yrxyear/Active-Noise-Cancelling-Method-for-An-Electro-Optical-Detection-System/dissertation-sheet.tex

% this file is used by HDR these to generate the formal
% Thesis/Dissertation Sheet

\ThesisFamilyName{Yang}
\ThesisGivenName{Ruixing}
\ThesisOtherNames{} %if any, set to {} if not used

\ThesisAbbreviatedDegree{MPhil}

\begin{ThesisAbstract}

\end{ThesisAbstract}
