yrxyear/Active-Noise-Cancelling-Method-for-An-Electro-Optical-Detection-System/1-pre/abstract.tex

\chapter{Abstract}

An optical-electrode or ``Optrode'' is a recently developed nerve signal detection device. Optrodes are used in electro-optical detection systems to convert nerve signals into light signals. Compared to conventional electrode detection systems, this system has the advantages of lower electrical interference, low signal attenuation, and small volume. However, the current electro-optical systems' output noise levels are much higher compare to conventional electrode systems. This means it is harder to observe nerve activity, especially when the amplitude is small. Noise in the optrode system is mainly produced by the light source, which suggests the possibility of active noise canceling.

An active noise canceling method for the electro-optical detection system for better detection results is proposed in this project. By using a light splitter at the output of the light source, two channels of light that contain almost identical noise can be formed. By connecting the exact same optrode sensing circuit to the two channels, the noise output of the two channels is very similar. Then, by applying a nerve signal to the optrode in one channel and a zero signal to the optrode in the other channel, we get one channel to output a combination of noise and nerve signals, and the other channel to output only noise. By converting the light signals into digital signals and applying a suitable digital signal processing algorithm, the noise can be largely removed and a clean nerve signal can be recovered.

In this project, a light receiver board which converts and amplifies two channels of light to digital signals has been designed, constructed and tested.  The digitised signals from the light receiver board receiver board are passed to an FPGA development board on which an adaptive filter algorithm has been implemented to actively cancel the noise. Experiments were conducted to test the system noise floor, and the system's responses to sine wave signals and simulated cardiac signals applied to the active optrode. Results show up to a 50\% reduction of the receiver system's noise floor when the active noise cancelling was activated, thus the ability to recover very low amplitude signals.  It can also reduce the artifact caused by moving the system physically.
