yrxyear/Active-Noise-Cancelling-Method-for-An-Electro-Optical-Detection-System/1-pre/publications.tex

\chapter{Publications and Presentations}

\section*{List of Publications}
 
\begin{itemize}
    \item R. Yang, Y. Chen, F. Ladouceur, N. H. Lovell, A. Al Abed, and T. Lehmann, ``Active Noise Cancelling Method for An Electro-Optical Detection System,'' 2023 IEEE Nordic Circuits and Systems Conference (NorCAS), 2023, Accepted on Sept. 20, 2023.
\end{itemize}
