yrxyear/Active-Noise-Cancelling-Method-for-An-Electro-Optical-Detection-System/1-pre/abbreviations.tex

%\chapter{Abbreviations}

%%cat */*.tex | grep -wo "[A-Z]\+\{2,10\}" | sort | uniq -c | awk '{print $2}'

\nomenclature{RMS}{Root Mean Square}
\nomenclature{PM}{Polarization-maintaining}
\nomenclature{RF}{Radio Frequency}
\nomenclature{PCB}{Printed Circuit Board}
\nomenclature{FPGA}{Field Programmable Gate Array}
\nomenclature{HDL}{Hardware Description Language}
\nomenclature{DSP}{Digital Signal Processing}
\nomenclature{FIR}{Finite Impulse Response}
\nomenclature{FxLMS}{Filtered-X Least Mean Squares}
\nomenclature{ANC}{Active Noise Cancelling}
\nomenclature{LMS}{Least Mean Square}
\nomenclature{LUT}{Look Up Table}
\nomenclature{IOB}{Input Output Block}
\nomenclature{IO}{Input Output}
\nomenclature{AC}{Alternating Current}
\nomenclature{DC}{Direct Current}
\nomenclature{MOSFET}{Metal-oxide-semiconductor Field-effect Transistor}
\nomenclature{EMI}{Electromagnetic Interference}
\nomenclature{DAC}{Digital-to-Analog Converter}
\nomenclature{ADC}{Analog-to-Digital Converters}
\nomenclature{SPI}{Serial Peripheral Interface}
\nomenclature{I2C}{Inter-Integrated Circuit}
\nomenclature{LDO}{Low-dropout}
\nomenclature{BCI}{Brain-computer Interface}
\nomenclature{RTL}{Register-transfer Level}
\nomenclature{USB}{Universal Serial Bus}
\nomenclature{APSoCs)}{All Programmable System-on-Chips}
\nomenclature{PC}{Personal Computer}
\nomenclature{LED}{Light Emitting Diode}
\nomenclature{SD Card}{Secure Digital Card}
\nomenclature{FIFO}{First In First Out}

\printnomenclature[5em]
