yrxyear/Active-Noise-Cancelling-Method-for-An-Electro-Optical-Detection-System/3-literature/zero_mode_sch.png

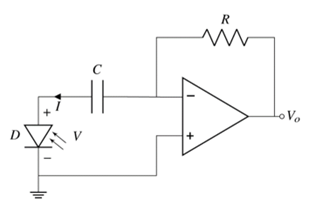
3-literature/zero_mode_sch.png
