yrxyear/Active-Noise-Cancelling-Method-for-An-Electro-Optical-Detection-System/5-Experiment/Cross correlation.pdf

100 | 200 | 300 | 400 | 500 | 600 | 700 | 800
Light Source Current (mA)

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
Cross correlation at 0 lag
