yrxyear/Active-Noise-Cancelling-Method-for-An-Electro-Optical-Detection-System/5-Experiment/RMS for Signal and Noise.pdf

RMS

200 | 300 | 400 | 500 | 600 | 700 | 800
Light Source Current (mA)

0

0.1

0.2

0.3

0.4

0.5

Voltage (V)

Signal RMS
Noise RMS
