yrxyear/Active-Noise-Cancelling-Method-for-An-Electro-Optical-Detection-System/5-Experiment/RMS value for ch1 and DSP output.pdf

100 | 200 | 300 | 400 | 500 | 600 | 700 | 800
Light Source Current (mA)

0

0.005

0.01

0.015

0.02

0.025

0.03

0.035

0.04

0.045

Voltage (V)

Active Optrode
Noise Canceling Output
