yrxyear/Active-Noise-Cancelling-Method-for-An-Electro-Optical-Detection-System/5-Experiment/Signal RMS (10mV input).pdf

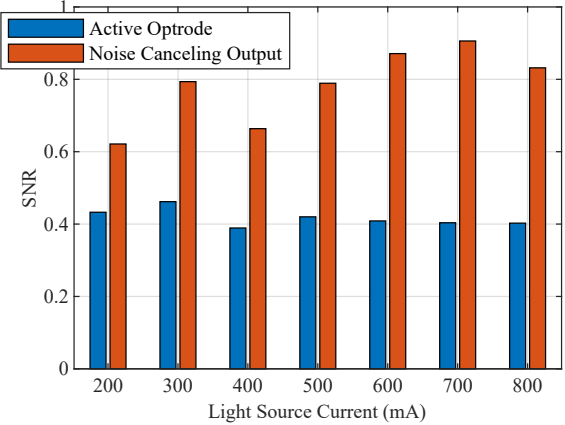
[picture p11: figure]
Light Source Current (mA); SNR; Active Optrode Noise Canceling Output
