yrxyear/Active-Noise-Cancelling-Method-for-An-Electro-Optical-Detection-System/5-Experiment/Signal to Noise Ratio of 200mV Input Amplitude.pdf

Signal to Noise Ratio of 200mV Input Amplitude

200 | 300 | 400 | 500 | 600 | 700 | 800
Light Source Current (mA)

0

5

10

15

20

25

30

Signal to Noise Ratio

Original Noise
Noise after ANC
