yrxyear/Active-Noise-Cancelling-Method-for-An-Electro-Optical-Detection-System/5-Experiment/SNR (10mV input).pdf

200 | 300 | 400 | 500 | 600 | 700 | 800
Light Source Current (mA)

0

0.2

0.4

0.6

0.81

1.2

SNR

Active Optrode
Noise Canceling Output
200 | 300 | 400 | 500 | 600 | 700 | 800
Light Source Current (mA)

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
SNR improvement (%)
