yrxyear/Active-Noise-Cancelling-Method-for-An-Electro-Optical-Detection-System/5-Experiment/SNR (200mV input).pdf

200 | 300 | 400 | 500 | 600 | 700 | 800
Light Source Current (mA)

02468

10

12

14

SNR

Active Optrode
Noise Canceling Output
200 | 300 | 400 | 500 | 600 | 700 | 800
Light Source Current (mA)

0

10

20

30

40

50

60

SNR improvement (%)
