yrxyear/Active-Noise-Cancelling-Method-for-An-Electro-Optical-Detection-System/5-Experiment/SNR improvment.pdf

SNR improvment

200 300 400 500 600 700 800 Light Source Current (mA)

0

0.5

1

1.5

2

2.5

SNR improvment
