yrxyear/Active-Noise-Cancelling-Method-for-An-Electro-Optical-Detection-System/4-ANC_Sys/SimulinkResult.pdf

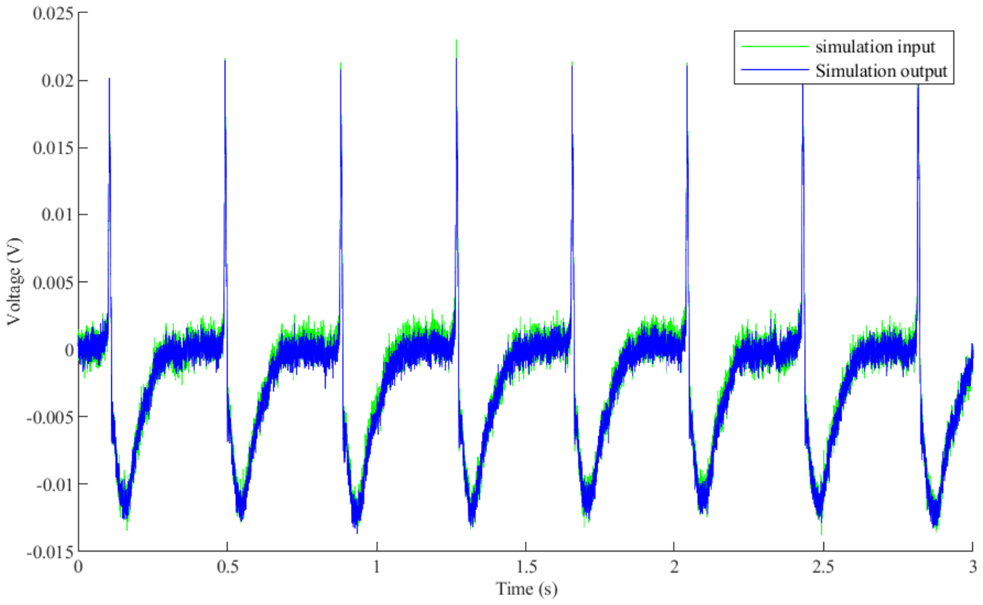
[picture p12: page 1]
