yrxyear/Active-Noise-Cancelling-Method-for-An-Electro-Optical-Detection-System/4-ANC_Sys/ReceiverAmplifierBoardSchematic_23_5_2023.pdf

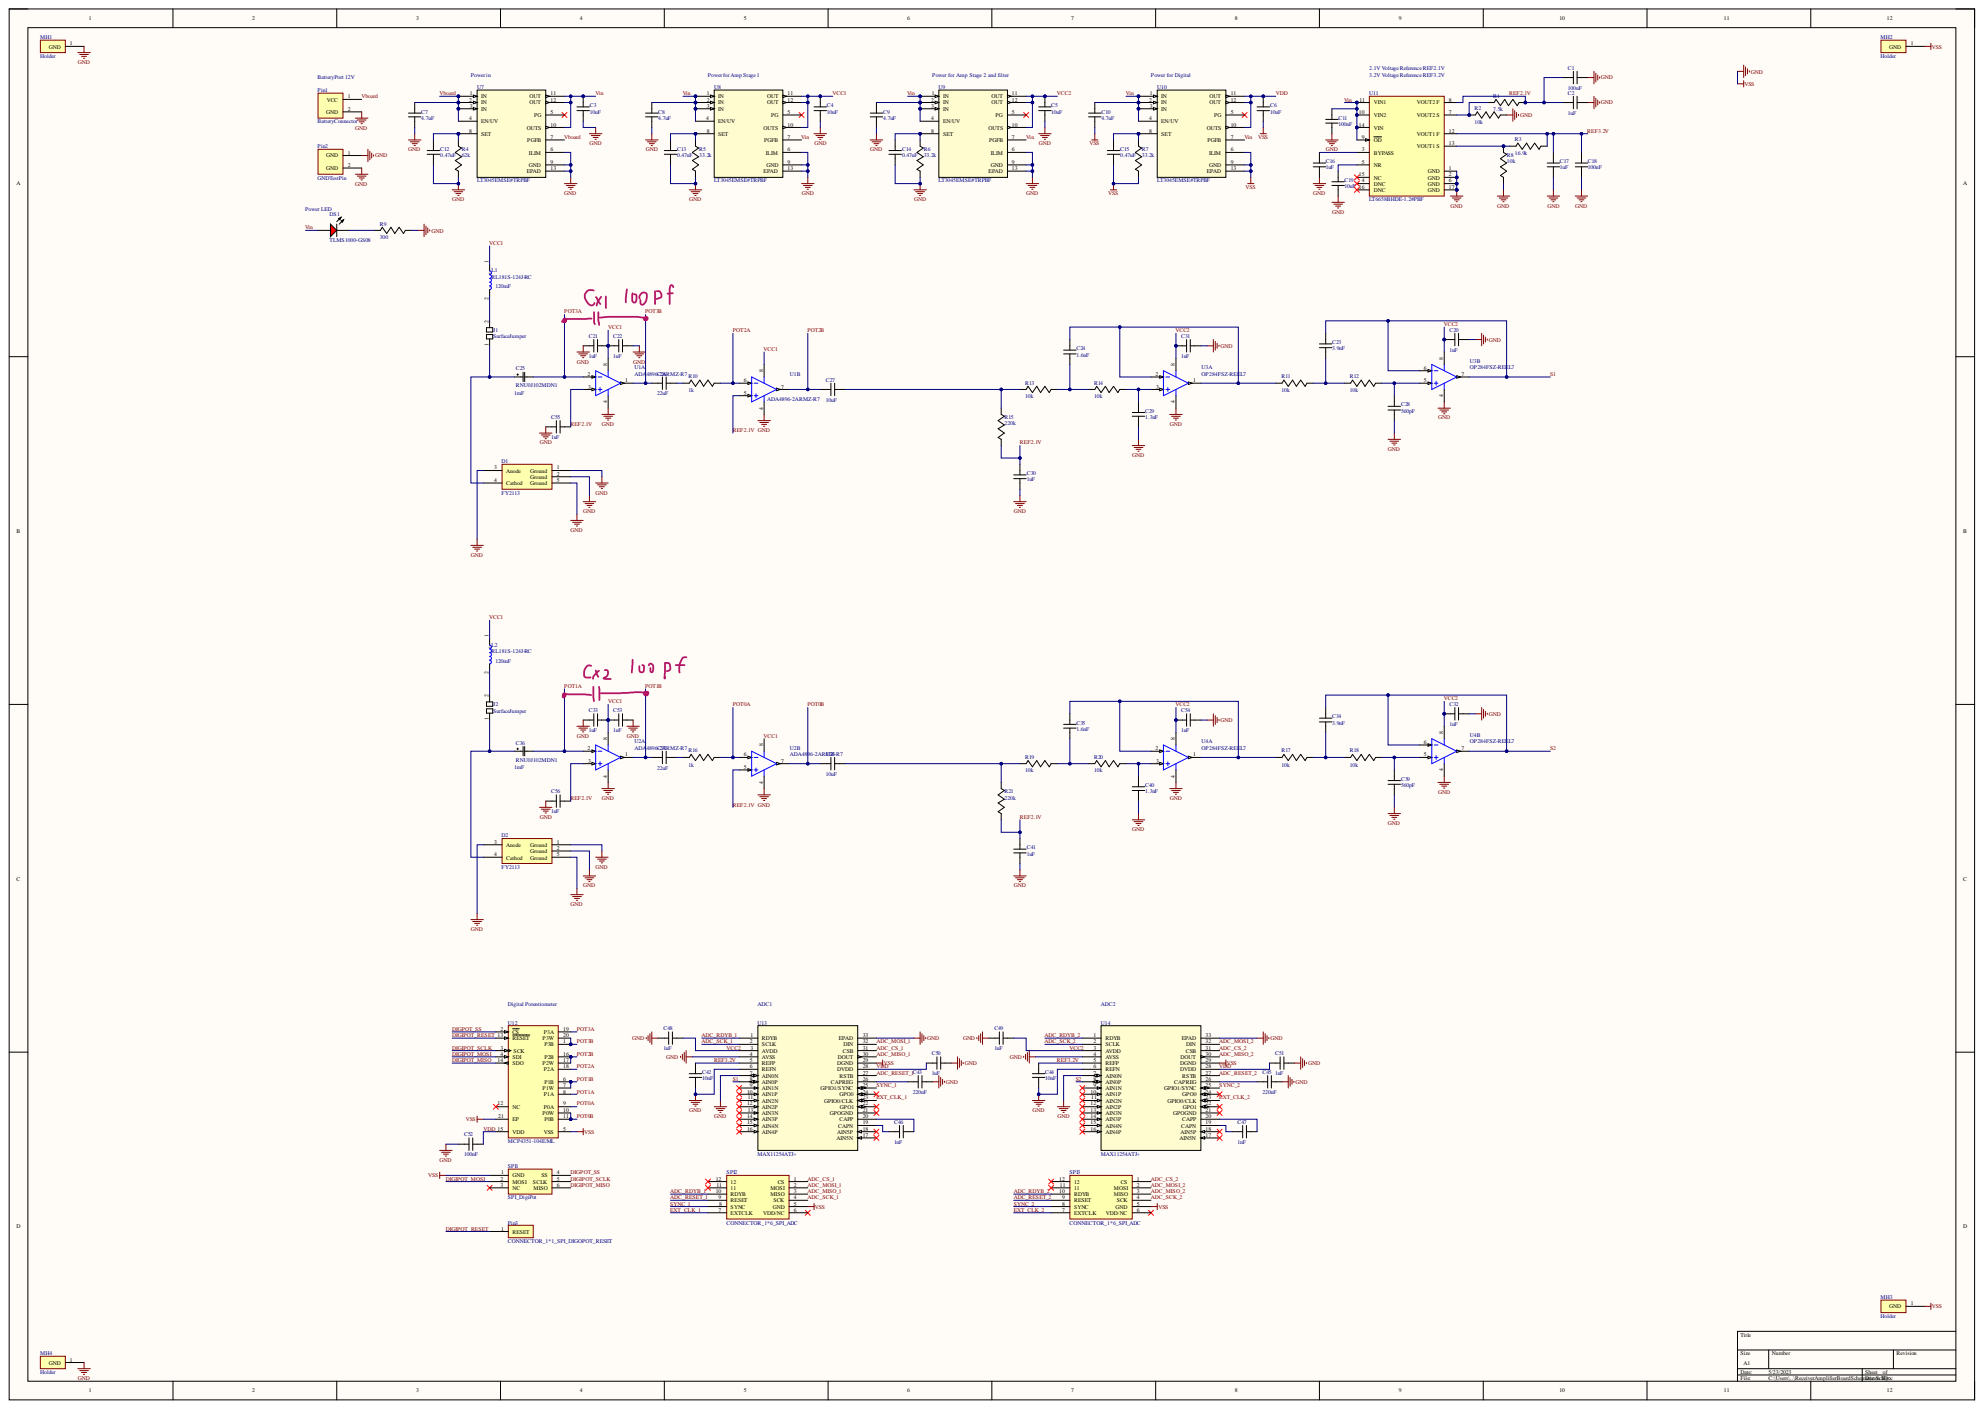
[picture p13: page 1]

Anode 3 Ground Cathod 4 Ground | 2
