yrxyear/Active-Noise-Cancelling-Method-for-An-Electro-Optical-Detection-System/5-Experiment/SimCardiac.pdf

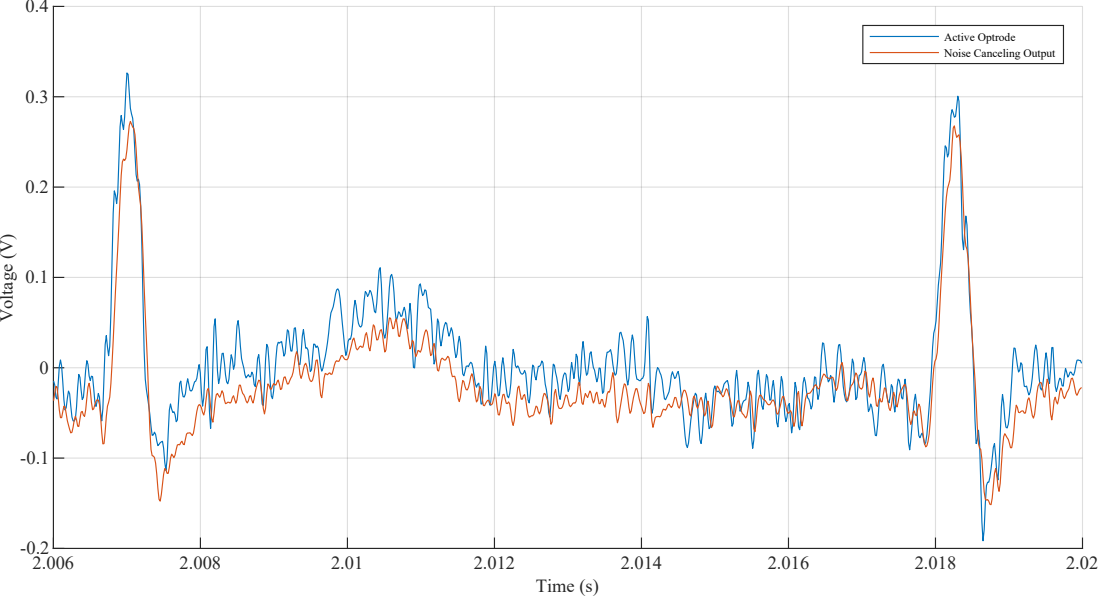
[picture p14: page 1]
Time (s); Voltage (V)

Active Optrode
Noise Canceling Output
