yrxyear/Active-Noise-Cancelling-Method-for-An-Electro-Optical-Detection-System/5-Experiment/500mA Signal_a.pdf

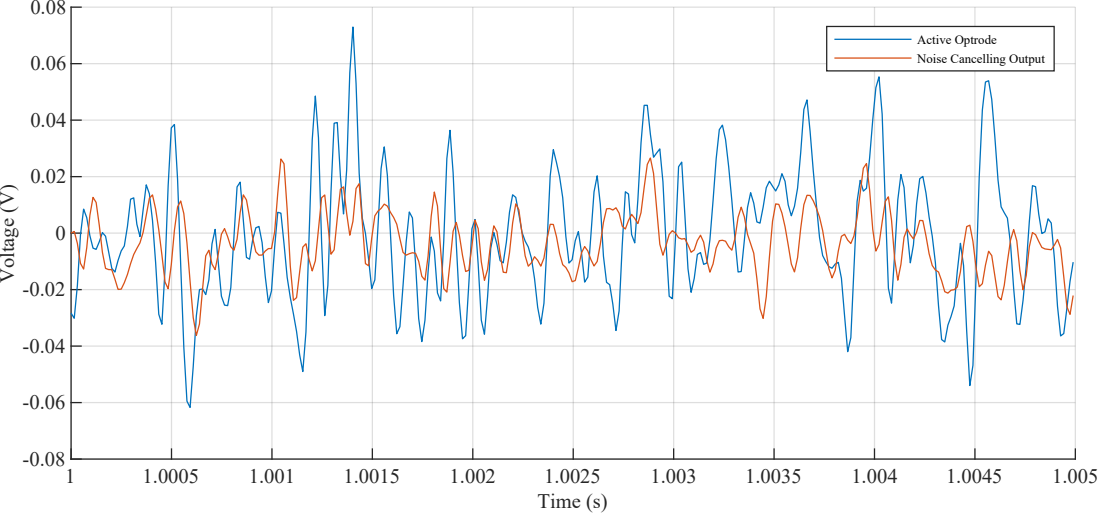
[picture p15: page 1]
Time (s); Voltage (V)

Active Optrode
Noise Cancelling Output
