yrxyear/Active-Noise-Cancelling-Method-for-An-Electro-Optical-Detection-System/5-Experiment/500mA Signal_c.pdf

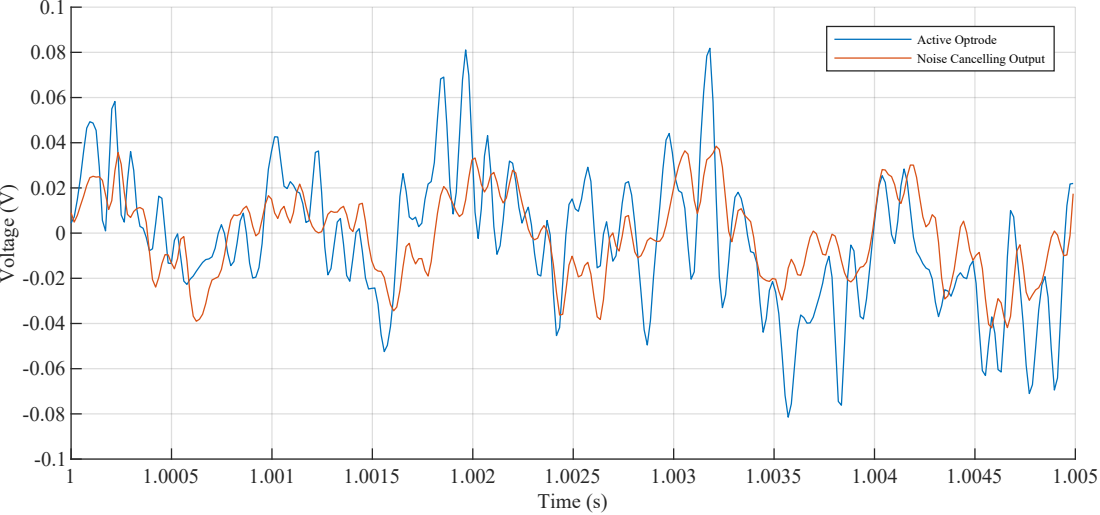
[picture p17: page 1]
Time (s); Voltage (V)

Active Optrode
Noise Cancelling Output
