yrxyear/Active-Noise-Cancelling-Method-for-An-Electro-Optical-Detection-System/4-ANC_Sys/CrossCoTest.pdf

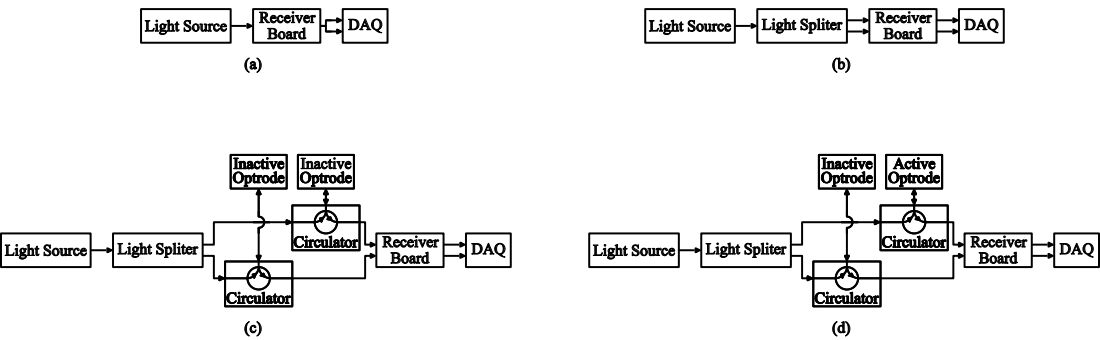
[picture p18: page 1]
Light Source; Receiver; Board; DAQ; Board Light Spliter; Inactive Optrode; Circulator; Optrode; Active Optrode; Inactive
