yrxyear/Active-Noise-Cancelling-Method-for-An-Electro-Optical-Detection-System/4-ANC_Sys/TestMeasurement.pdf

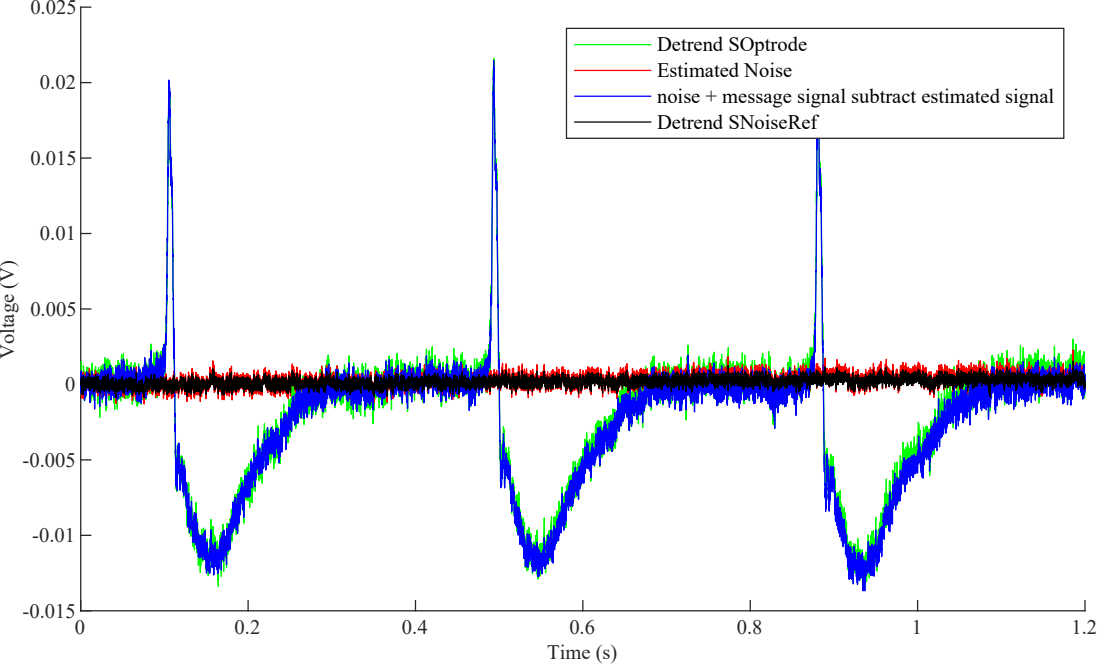
[picture p19: page 1]
Time (s); Voltage (V)

Detrend SOptrode
Estimated Noise
noise + message signal subtract estimated signal
Detrend SNoiseRef
