yrxyear/Active-Noise-Cancelling-Method-for-An-Electro-Optical-Detection-System/5-Experiment/500mA Signal.pdf

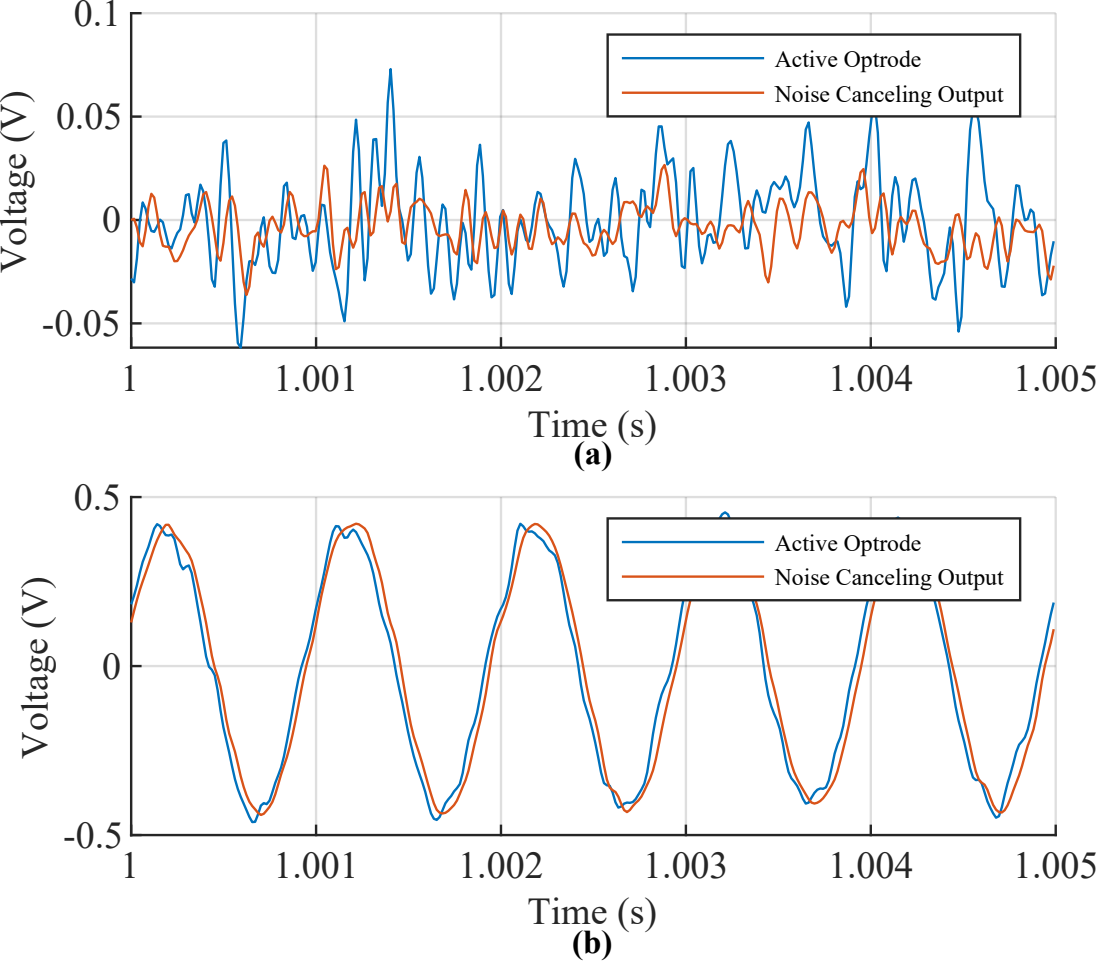
[picture p20: page 1]
Time (s); Voltage (V)

Active Optrode
Noise Canceling Output
