yrxyear/Active-Noise-Cancelling-Method-for-An-Electro-Optical-Detection-System/5-Experiment/Board Baseline Noise.pdf

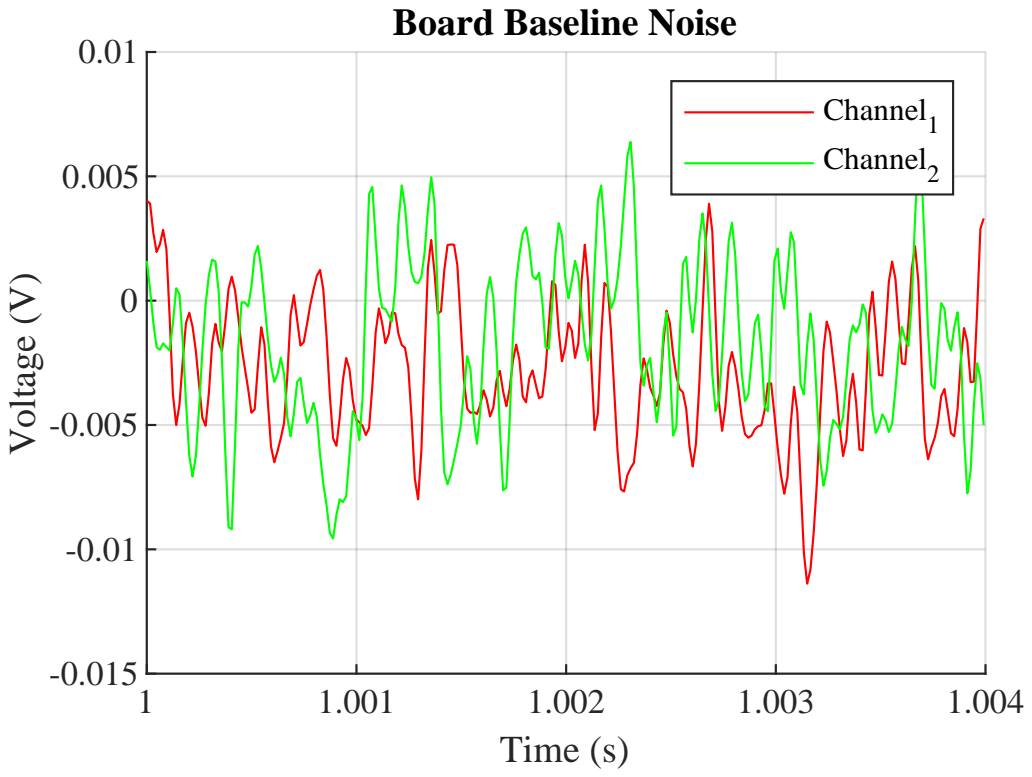
[picture p21: page 1]
Time (s); Voltage (V); Channel1 Channel2

Board Baseline Noise
