yrxyear/Active-Noise-Cancelling-Method-for-An-Electro-Optical-Detection-System/5-Experiment/Periodogram 500mA (10mV input).pdf

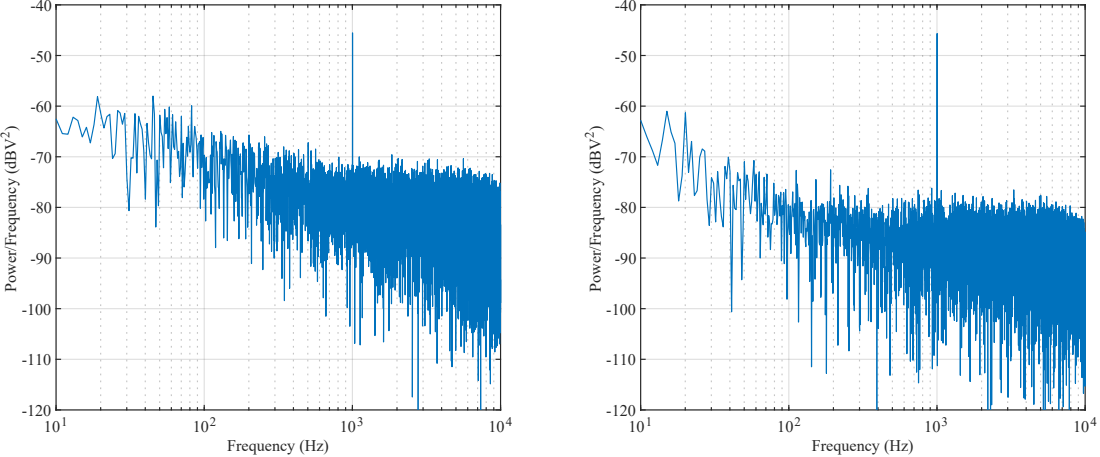
[picture p23: page 1]
Frequency (Hz); Power/Frequency (dBV2)
