yrxyear/Active-Noise-Cancelling-Method-for-An-Electro-Optical-Detection-System/4-ANC_Sys/NoiseZeroMode.pdf

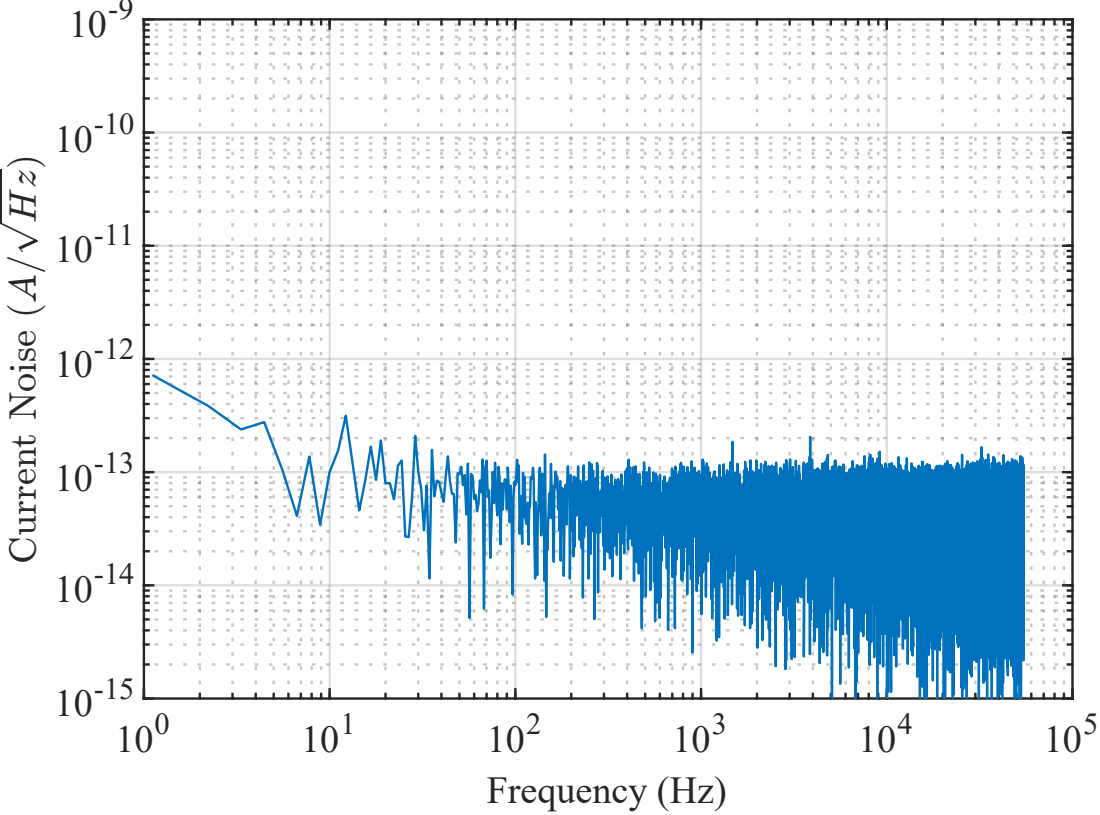
[picture p24: page 1]
Frequency (Hz)

Current Noise (A=pHz)
