yrxyear/Active-Noise-Cancelling-Method-for-An-Electro-Optical-Detection-System/4-ANC_Sys/PowerSupSch.pdf

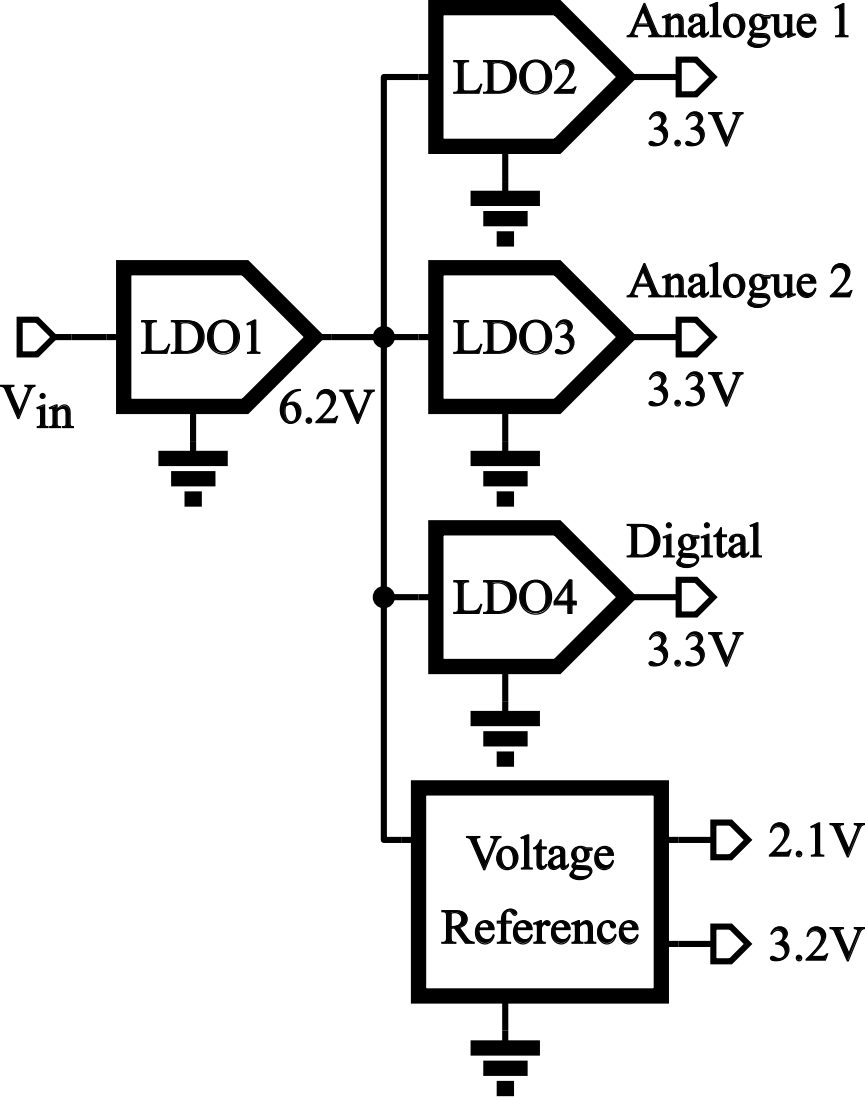
[picture p25: page 1]
LDO1; LDO3; LDO4; LDO2; Vin; Analogue 1; Analogue 2; Digital; Voltage Reference
