yrxyear/Active-Noise-Cancelling-Method-for-An-Electro-Optical-Detection-System/4-ANC_Sys/PCB_2.pdf

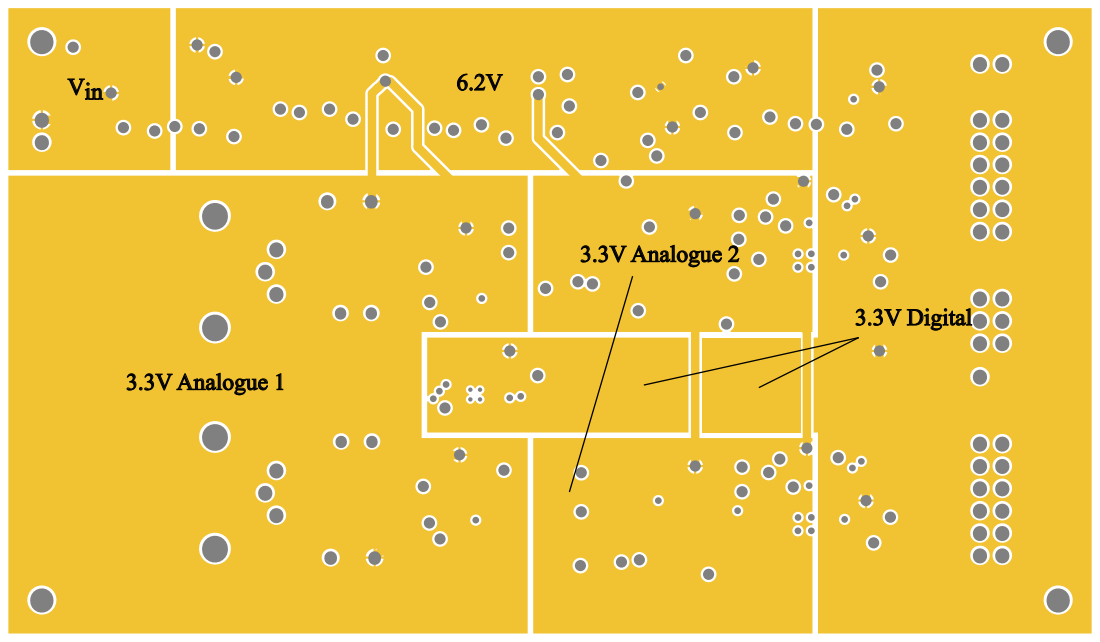
[picture p26: page 1]
3.3V Digital; Vin; 3.3V Analogue 1; 3.3V Analogue 2
