yrxyear/Active-Noise-Cancelling-Method-for-An-Electro-Optical-Detection-System/2-intro/OptrodeFigure.pdf

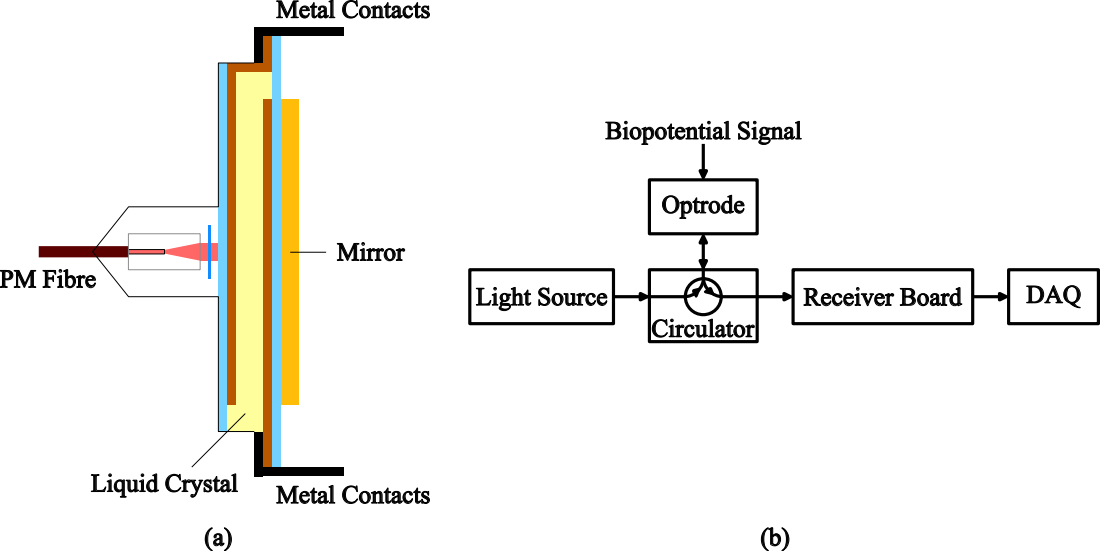
[picture p27: page 1]
PM Fibre; Liquid Crystal; Mirror; Metal Contacts; Circulator; Light Source; Optrode; Biopotential Signal; Receiver Board; DAQ
