yrxyear/Active-Noise-Cancelling-Method-for-An-Electro-Optical-Detection-System/4-ANC_Sys/ANCBlockDiagram.pdf

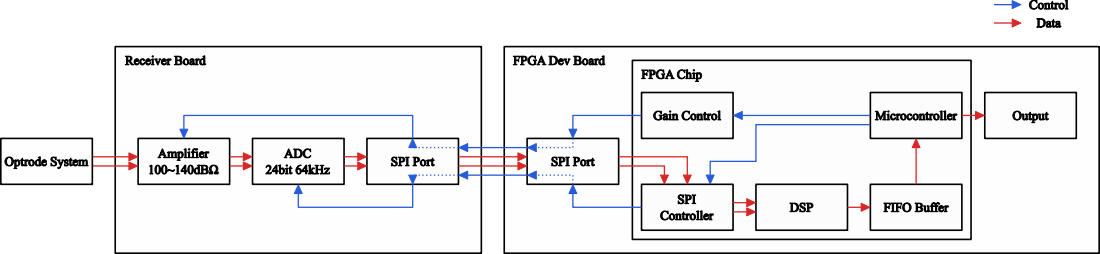
[picture p28: page 1]
Amplifier; 100~140dBΩ; SPI Port; Gain Control; Microcontroller; Output; DSP; FIFO Buffer; ADC 24bit 64kHz; SPI Controller; Receiver Board; FPGA Dev Board; FPGA Chip; Optrode System; Control Data
