yrxyear/Active-Noise-Cancelling-Method-for-An-Electro-Optical-Detection-System/4-ANC_Sys/ANCSysBlockDiagram.pdf

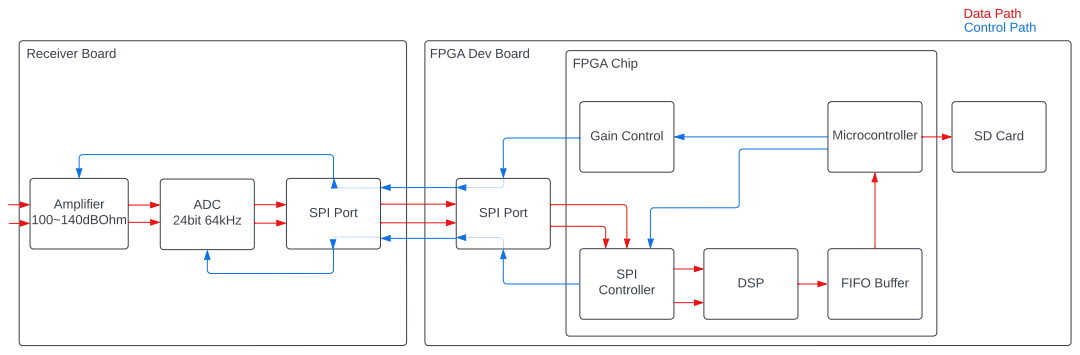
[picture p29: page 1]
Data Path; FPGA Chip; Amplifier 100~140dBOhm; ADC 24bit 64kHz; SPI Port; Gain Control; FIFO Buffer; SPI; Controller; DSP; Microcontroller; SD Card; Receiver Board; FPGA Dev Board; Control Path
