yrxyear/Active-Noise-Cancelling-Method-for-An-Electro-Optical-Detection-System/4-ANC_Sys/LTspiceAmp.pdf

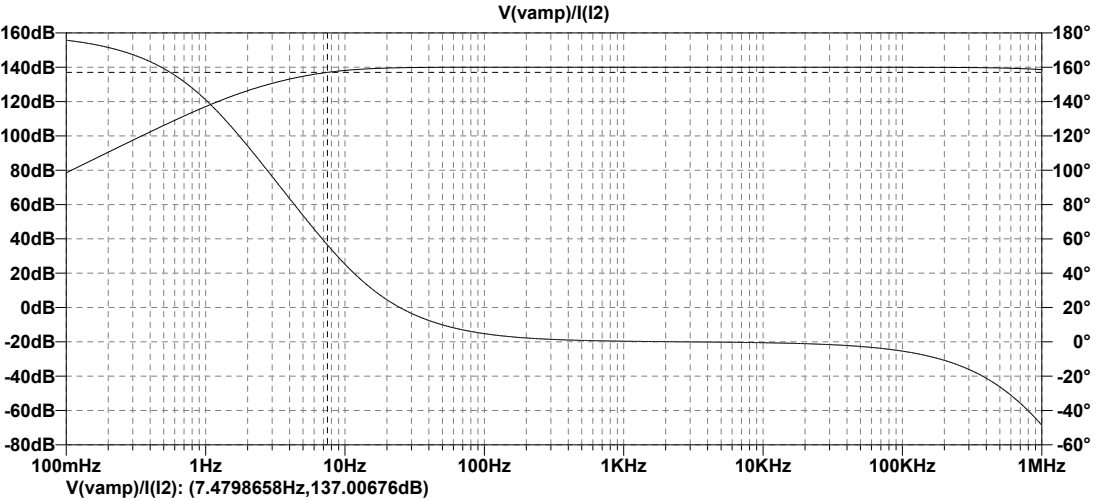
[picture p30: page 1]
100mHz; 1KHz; 10KHz; 100KHz; 1MHz; V(vamp)/I(I2); V(vamp)/I(I2): (7.4798658Hz,137.00676dB) --- C:\Users\Rex\OneDrive\#UNSW\#MASTER\# PCB&FPGA\LTsice\ReceiverFilter.asc ---
