yrxyear/Active-Noise-Cancelling-Method-for-An-Electro-Optical-Detection-System/4-ANC_Sys/LTspiceLPF.pdf

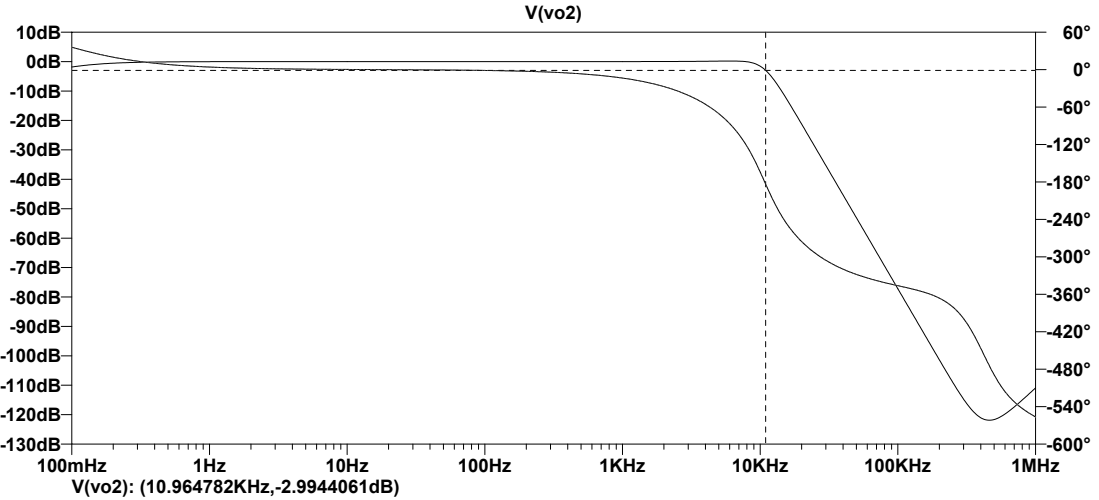
[picture p31: page 1]
100mHz; 1KHz; 10KHz; 100KHz; 1MHz; V(vo2): (10.964782KHz,-2.9944061dB) --- C:\Users\Rex\OneDrive\#UNSW\#MASTER\# PCB&FPGA\LTsice\ReceiverFilter.asc ---
