yrxyear/Active-Noise-Cancelling-Method-for-An-Electro-Optical-Detection-System/4-ANC_Sys/NoiseReverseBias.pdf

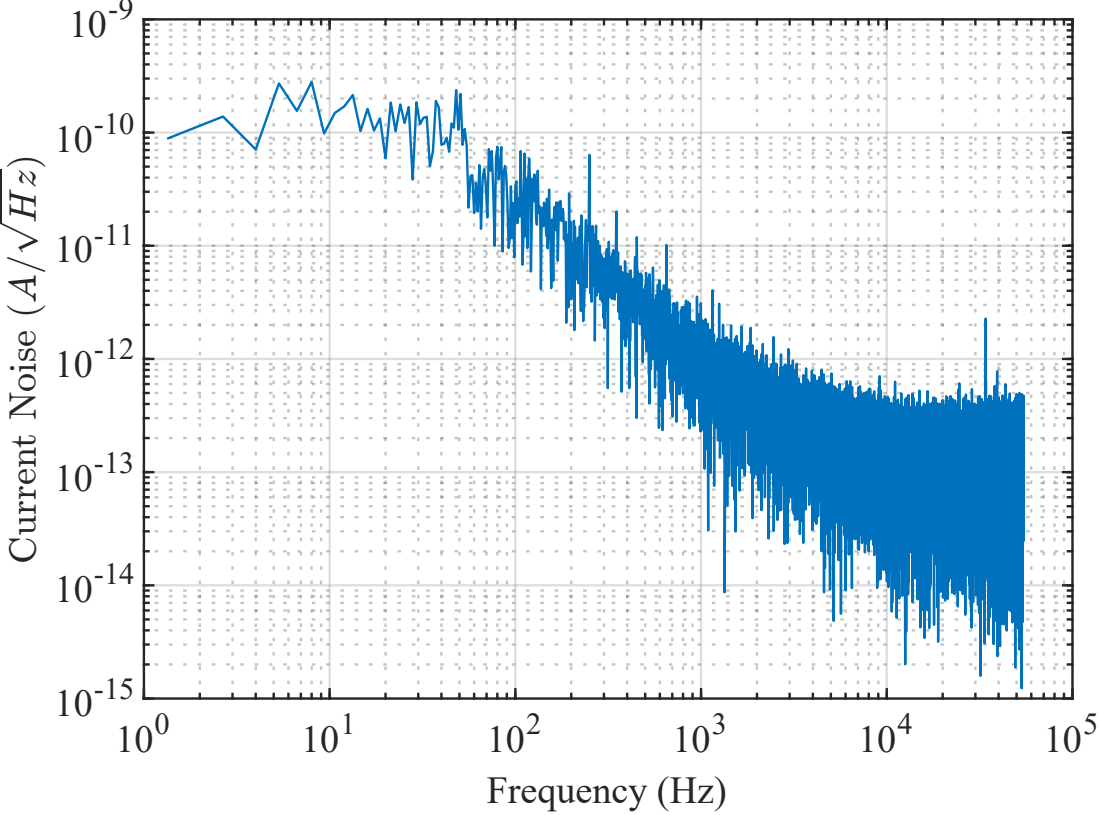
[picture p32: page 1]
Frequency (Hz)

Current Noise (A=pHz)
