yrxyear/Active-Noise-Cancelling-Method-for-An-Electro-Optical-Detection-System/5-Experiment/CrossCoAfterANC.pdf

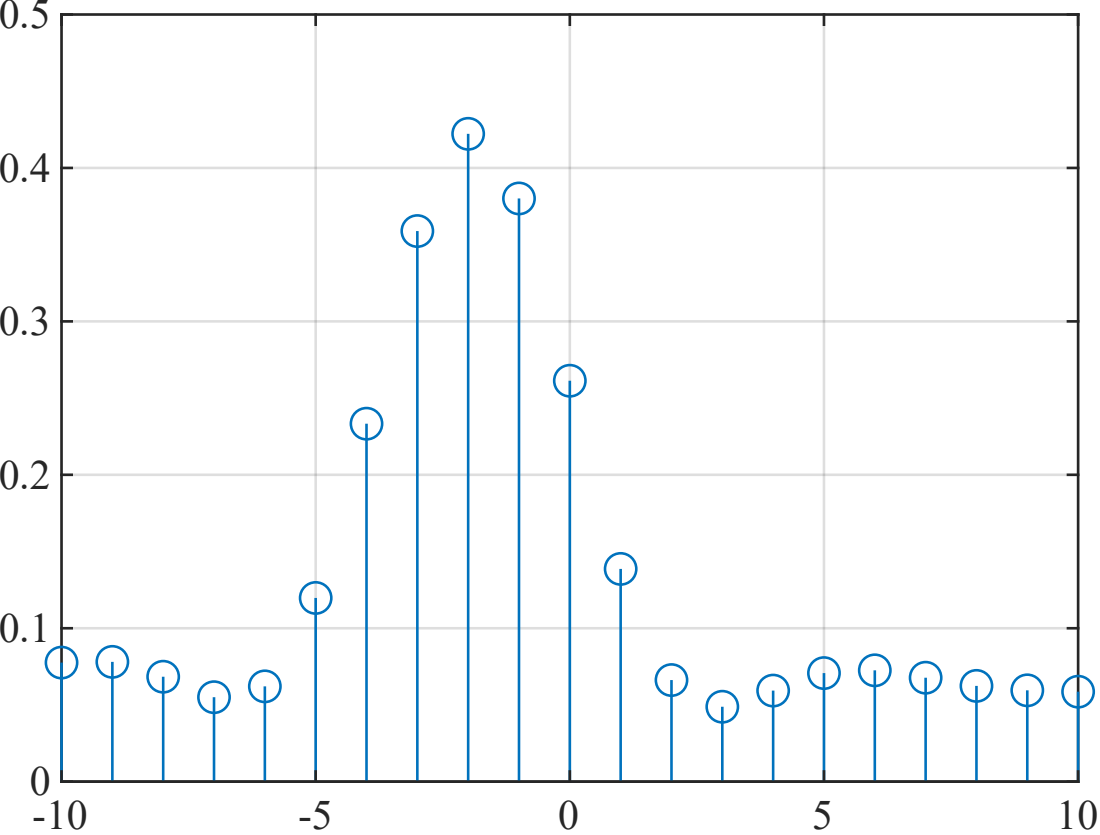
[picture p33: page 1]
