yrxyear/Active-Noise-Cancelling-Method-for-An-Electro-Optical-Detection-System/5-Experiment/CrossCoBeforeANC.pdf

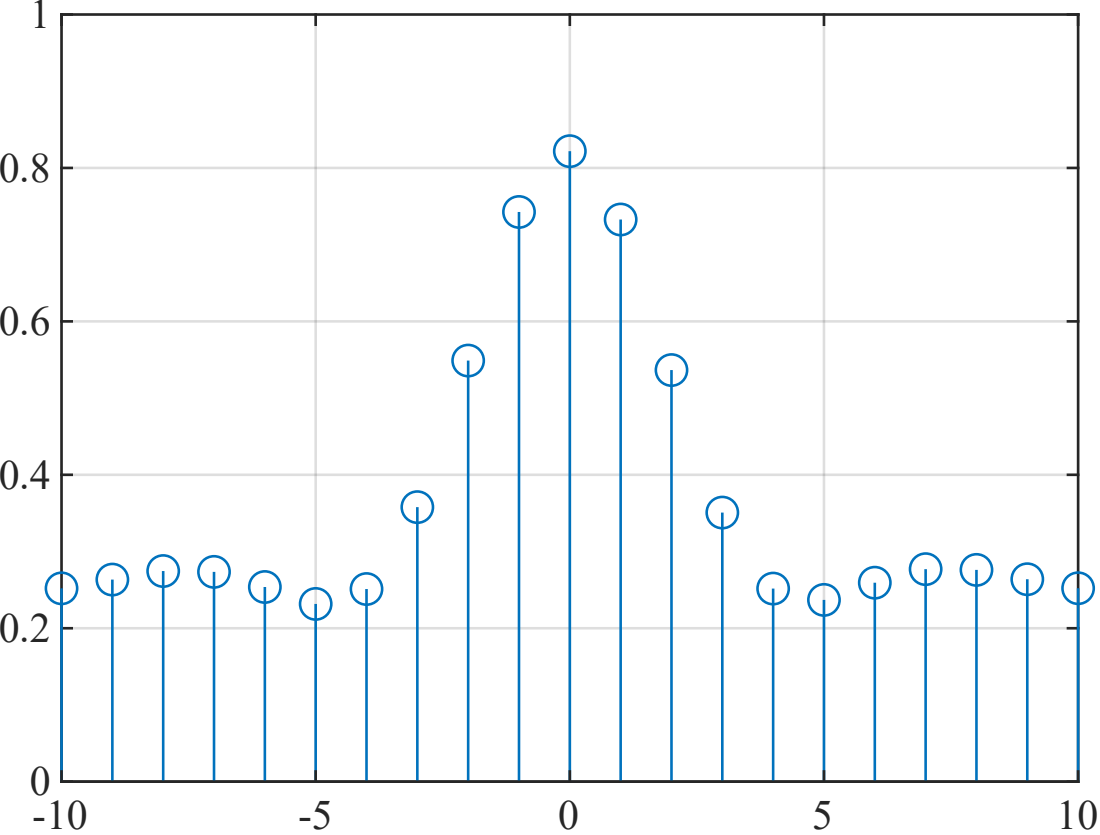
[picture p34: page 1]
