yrxyear/Active-Noise-Cancelling-Method-for-An-Electro-Optical-Detection-System/4-ANC_Sys/DSP.pdf

x
H

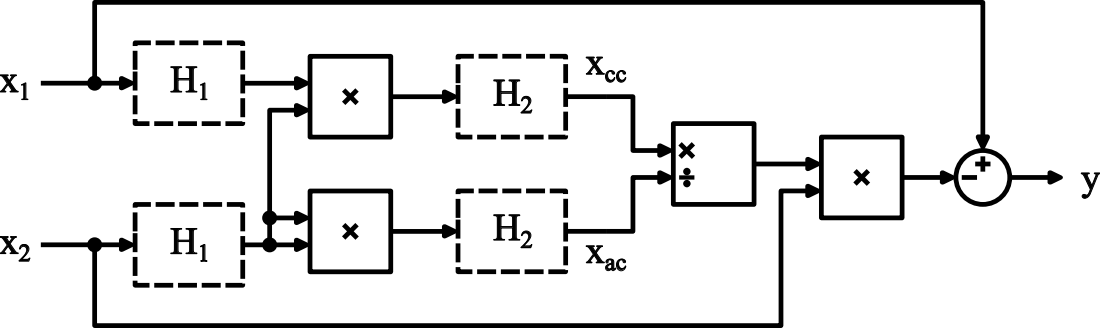
[picture p35: page 1]
