yrxyear/Active-Noise-Cancelling-Method-for-An-Electro-Optical-Detection-System/4-ANC_Sys/ModifiedWiener.pdf

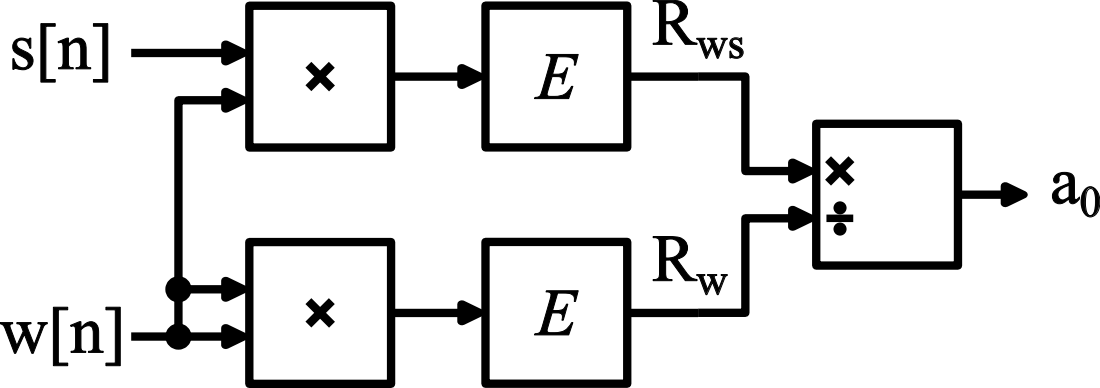
[picture p36: page 1]
