yrxyear/Active-Noise-Cancelling-Method-for-An-Electro-Optical-Detection-System/4-ANC_Sys/LTspiceAmpSch.pdf

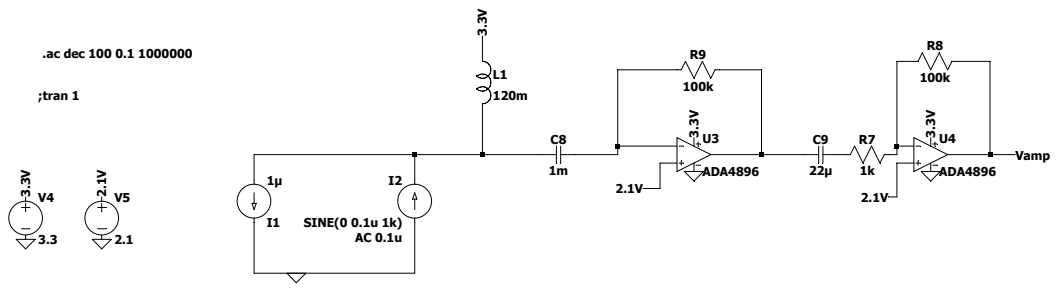
[picture p37: page 1]
