yrxyear/Active-Noise-Cancelling-Method-for-An-Electro-Optical-Detection-System/4-ANC_Sys/SallenKeyLPF.pdf

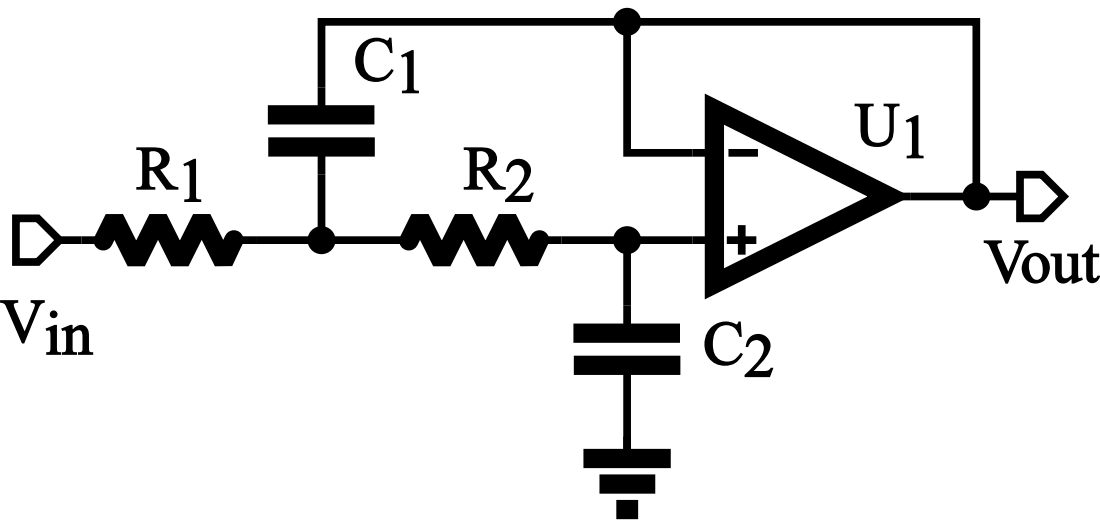
[picture p38: page 1]
