yrxyear/Active-Noise-Cancelling-Method-for-An-Electro-Optical-Detection-System/4-ANC_Sys/PCB_3.pdf

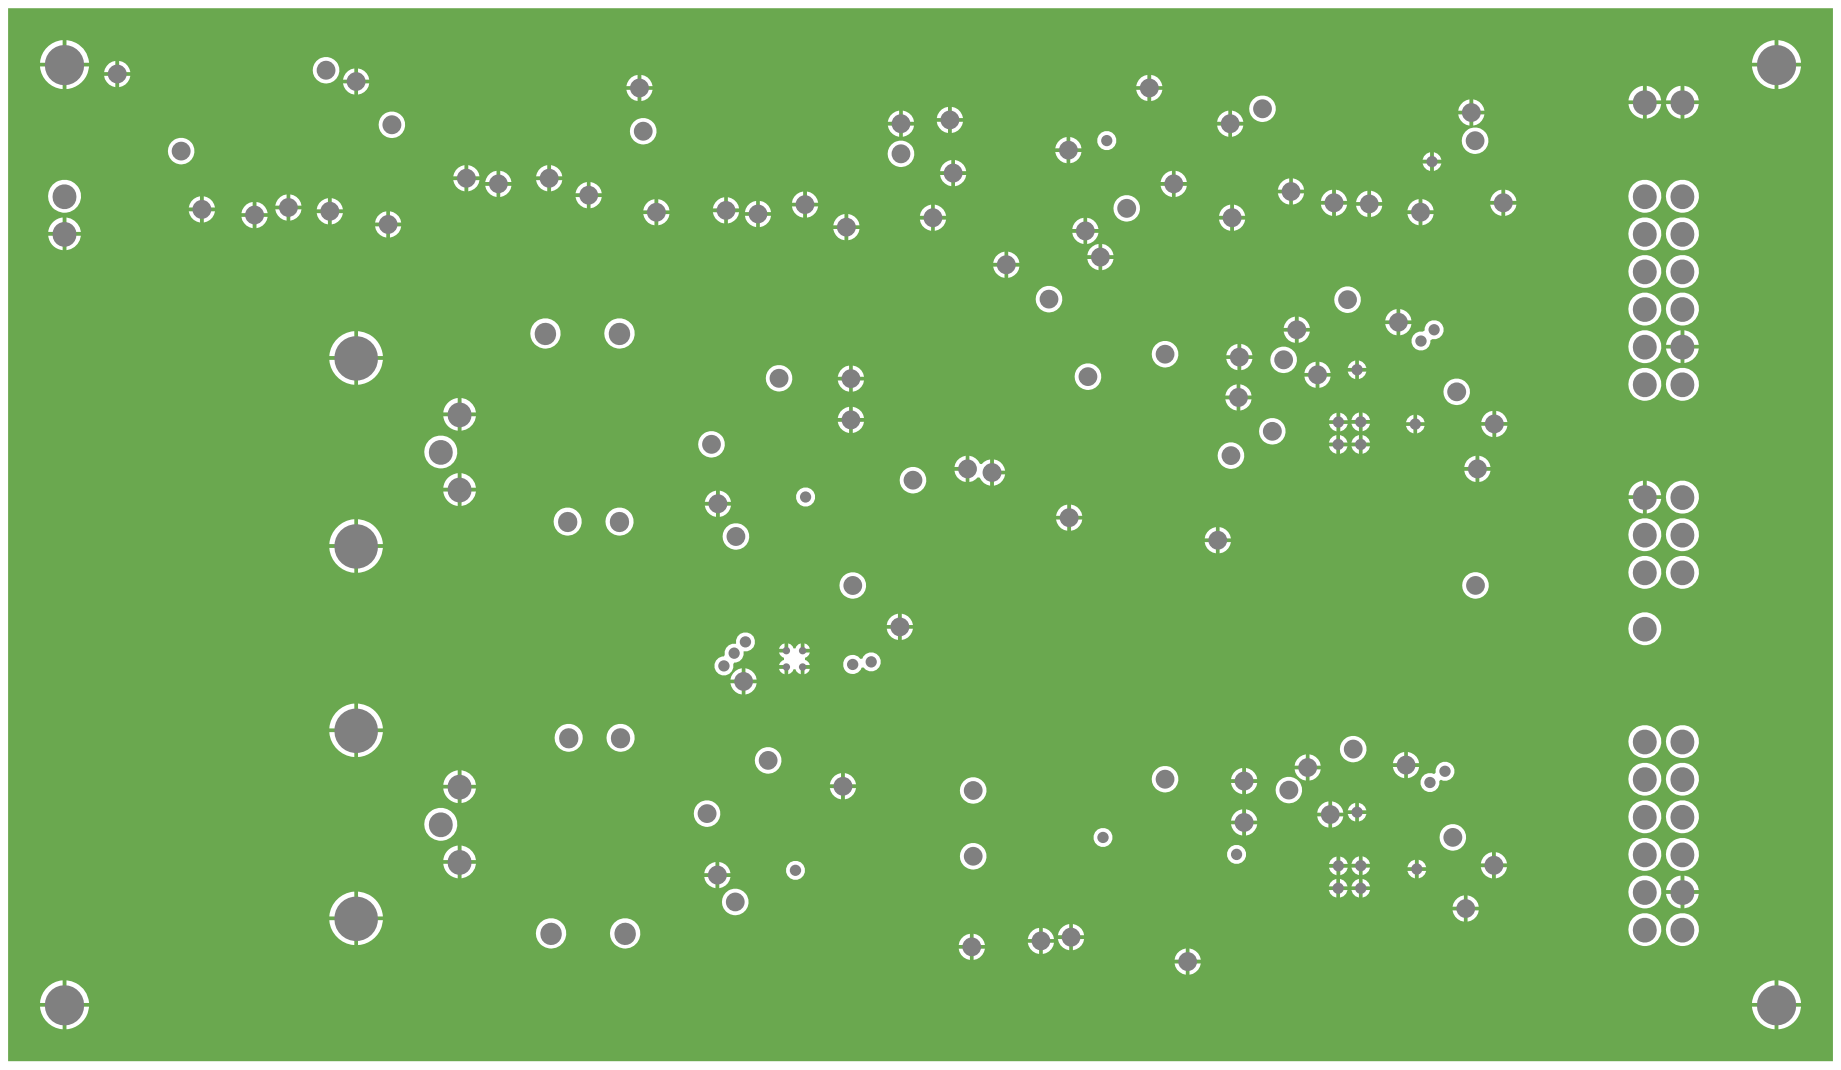
[picture p40: page 1]
