yrxyear/Active-Noise-Cancelling-Method-for-An-Electro-Optical-Detection-System/4-ANC_Sys/PCB_4.pdf

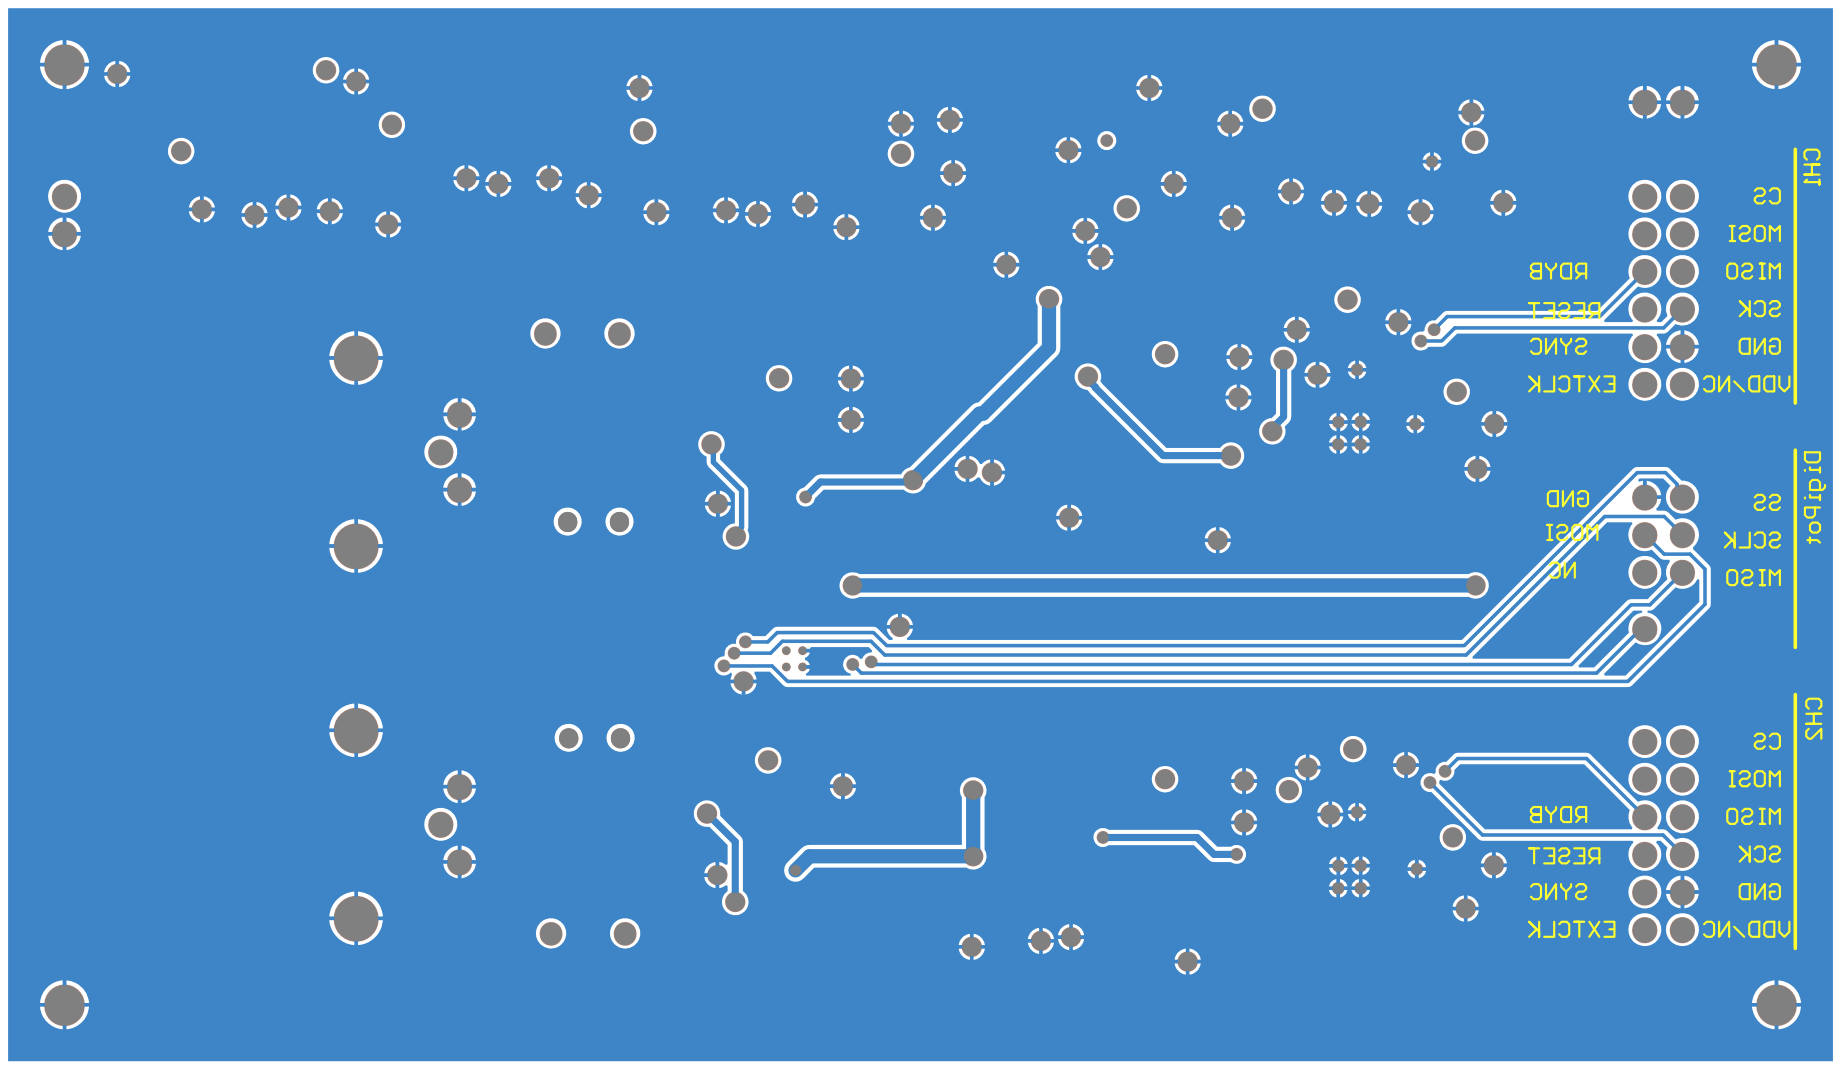
[picture p41: page 1]
