yrxyear/Active-Noise-Cancelling-Method-for-An-Electro-Optical-Detection-System/4-ANC_Sys/VivadoBD.pdf

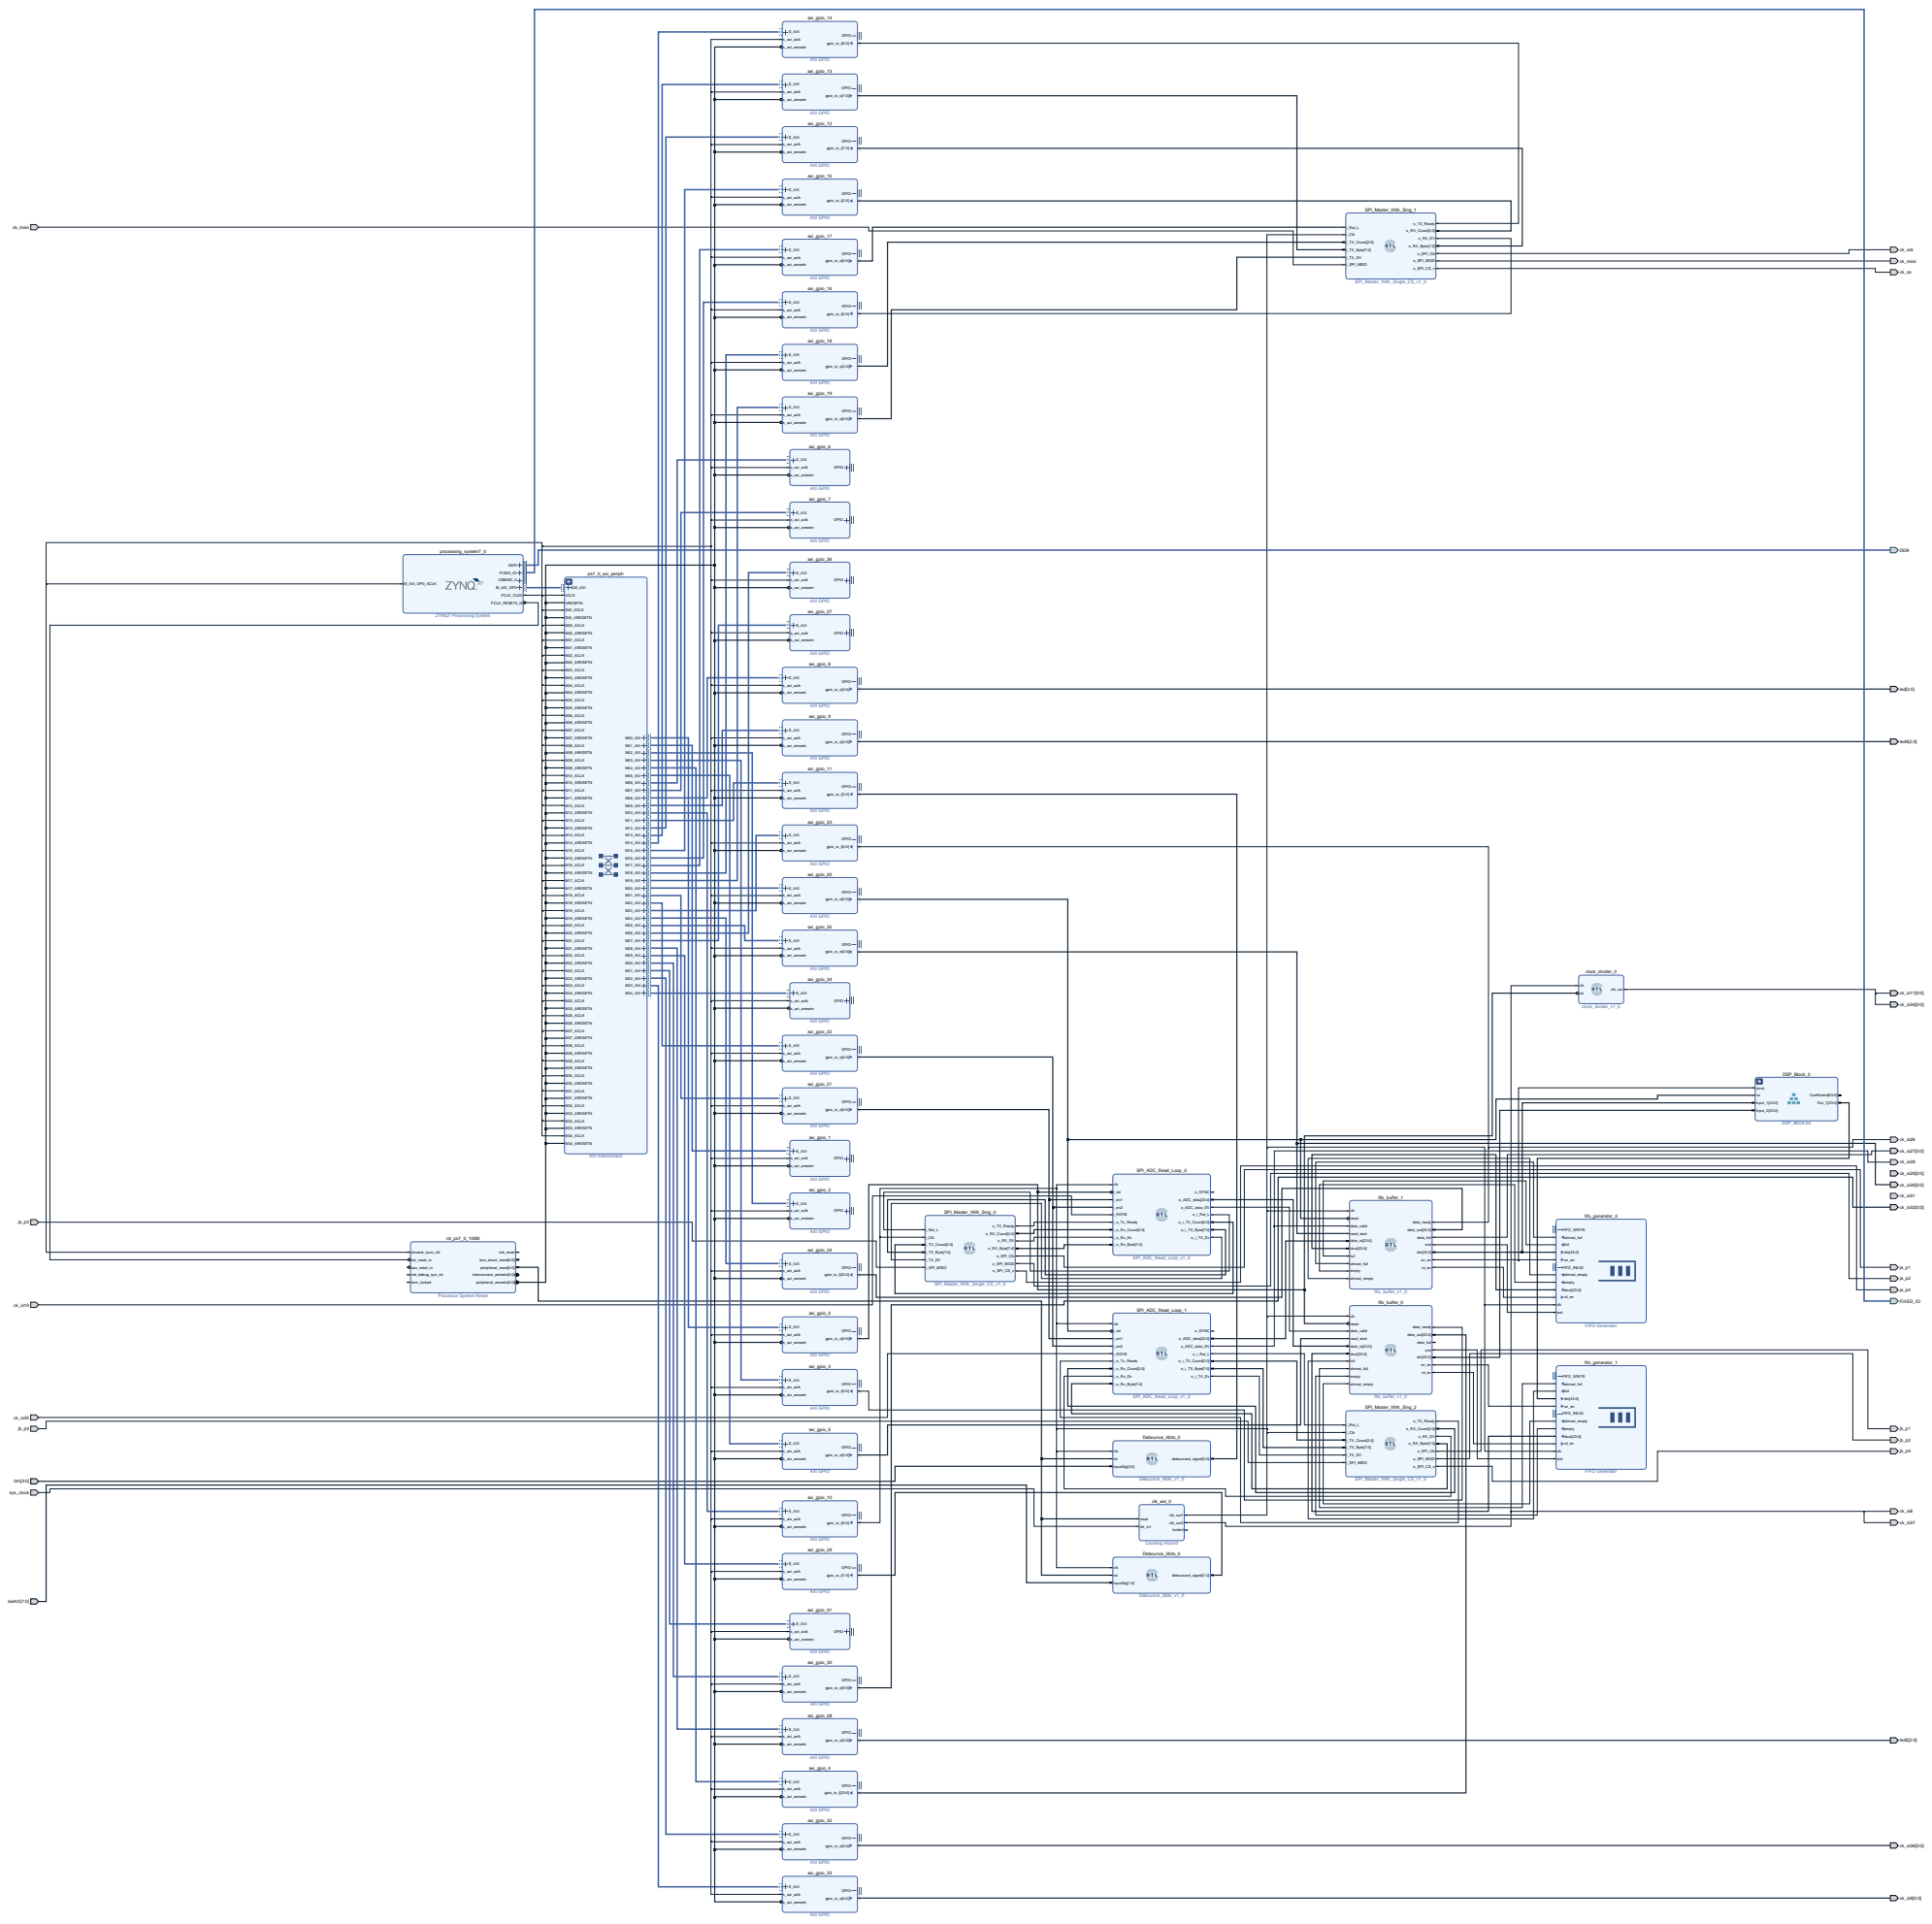
[picture p42: page 1]
DDR; DSP_Block_0; DSP_Block.bd; clock; rst; Coefficient[63:0]; Input_1[23:0]; Input_2[23:0]; Out_1[23:0]; Debounce_2bits_0; Debounce_2bits_v1_0; clk rst; inputSig[1:0]; debounced_signal[1:0]; Debounce_4bits_0; Debounce_4bits_v1_0; inputSig[3:0]; debounced_signal[3:0]; FIXED_IO; SPI_ADC_Read_Loop_0; SPI_ADC_Read_Loop_v1_0; clk i_rst i_en1 i_en2 i_RDYB; o_SYNC o_ADC_data[23:0] o_ADC_data_DV; i_o_Tx_Ready i_o_Rx_Count[2:0] i_o_Rx_Dv i_o_Rx_Byte[7:0]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

Processor System Reset

axi_gpio_10 S_AXI GPIO gpio_io_i[0:0] s_axi_aclk s_axi_aresetn AXI GPIO | clk_wiz_0 reset clk_in1 clk_out1 clk_out2 locked
