yrxyear/Active-Noise-Cancelling-Method-for-An-Electro-Optical-Detection-System/4-ANC_Sys/VivadoBD_DSP.pdf

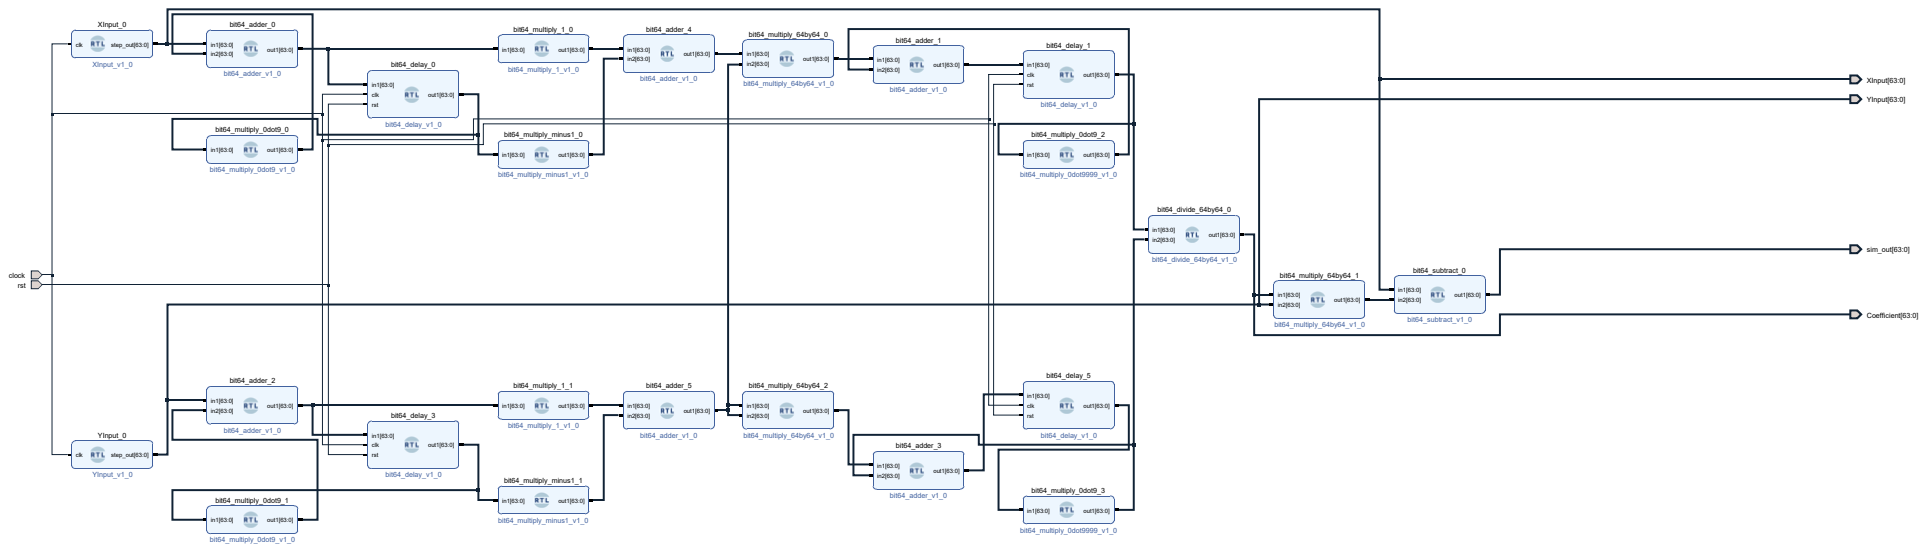
[picture p43: page 1]
clock rst; XInput_0; XInput_v1_0; clk; step_out[63:0]; YInput_0; YInput_v1_0; bit64_adder_0; bit64_adder_v1_0; out1[63:0]; bit64_multiply_0dot9_v1_0; bit64_adder_2; bit64_multiply_0dot9_1; bit64_delay_0; rst; bit64_delay_3; bit64_delay_v1_0; bit64_multiply_1_0; bit64_multiply_1_v1_0; bit64_multiply_minus1_v1_0; bit64_multiply_1_1; bit64_multiply_minus1_1; bit64_adder_4; bit64_adder_5; bit64_multiply_64by64_0; bit64_multiply_64by64_v1_0; bit64_multiply_64by64_2; bit64_adder_1; bit64_adder_3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

bit64_multiply_0dot9_0 | bit64_delay_v1_0 | bit64_multiply_minus1_0 | bit64_multiply_0dot9_2
