yrxyear/Active-Noise-Cancelling-Method-for-An-Electro-Optical-Detection-System/4-ANC_Sys/VivadoBD_DSP_onFPGA.pdf

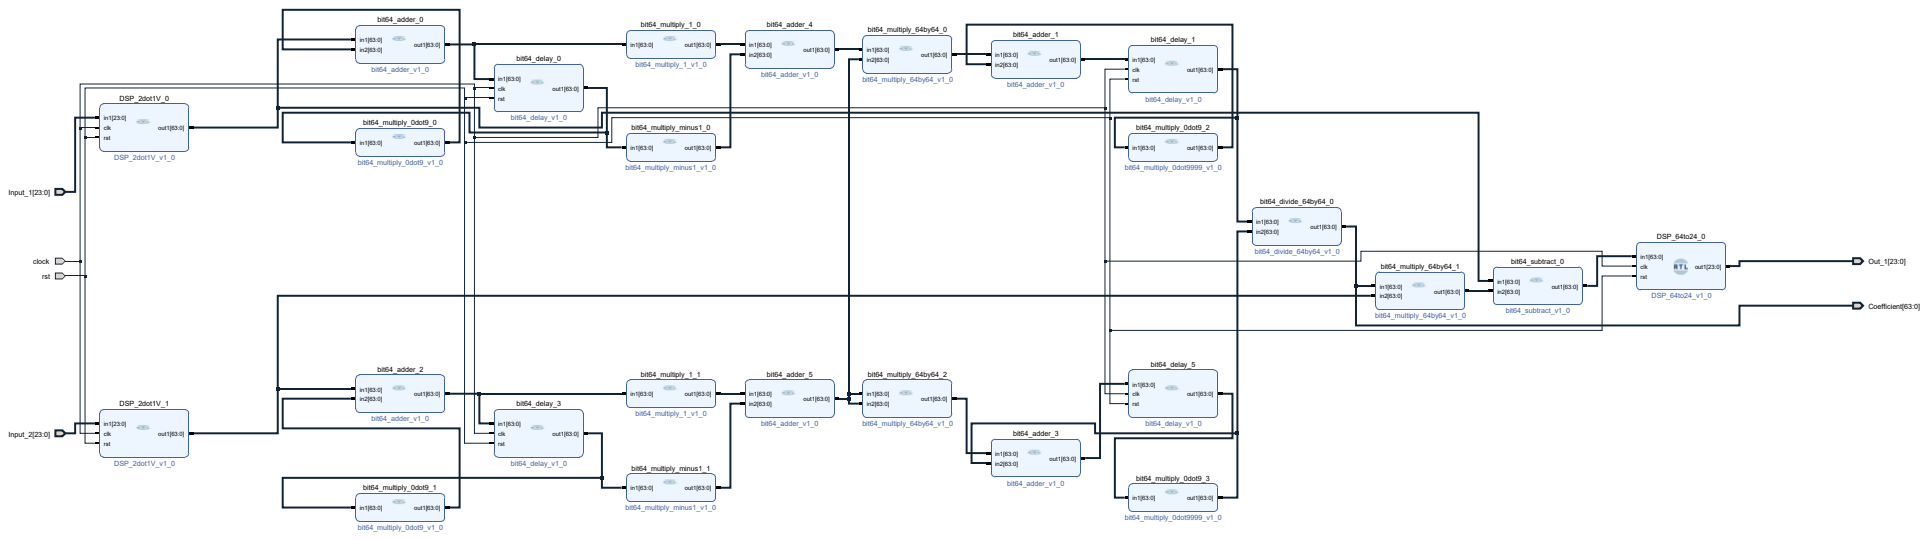
[picture p44: page 1]
Input_1[23:0]; clock; rst; Input_2[23:0]; DSP_2dot1V_0; DSP_2dot1V_v1_0; clk; out1[63:0]; DSP_2dot1V_1; bit64_adder_0; bit64_adder_v1_0; bit64_multiply_0dot9_0; bit64_multiply_0dot9_v1_0; bit64_adder_2; bit64_multiply_0dot9_1; bit64_delay_0; bit64_delay_v1_0; bit64_delay_3; bit64_multiply_1_0; bit64_multiply_1_v1_0; bit64_multiply_minus1_0; bit64_multiply_minus1_v1_0; bit64_multiply_1_1; bit64_multiply_minus1_1; bit64_adder_4; bit64_adder_5; bit64_multiply_64by64_0; bit64_multiply_64by64_v1_0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
