yrxyear/Active-Noise-Cancelling-Method-for-An-Electro-Optical-Detection-System/4-ANC_Sys/CrossCorrelation 30.pdf

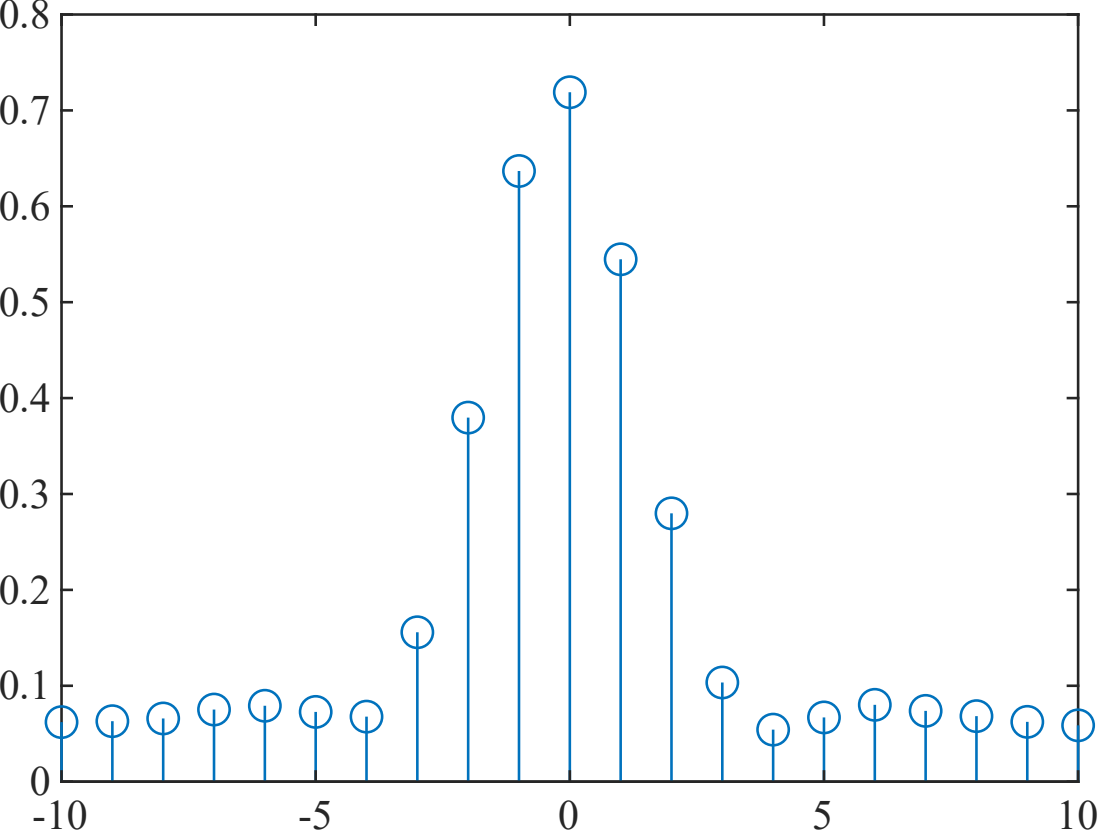
[picture p45: page 1]
