yrxyear/Active-Noise-Cancelling-Method-for-An-Electro-Optical-Detection-System/4-ANC_Sys/CrossCorrelation 32.pdf

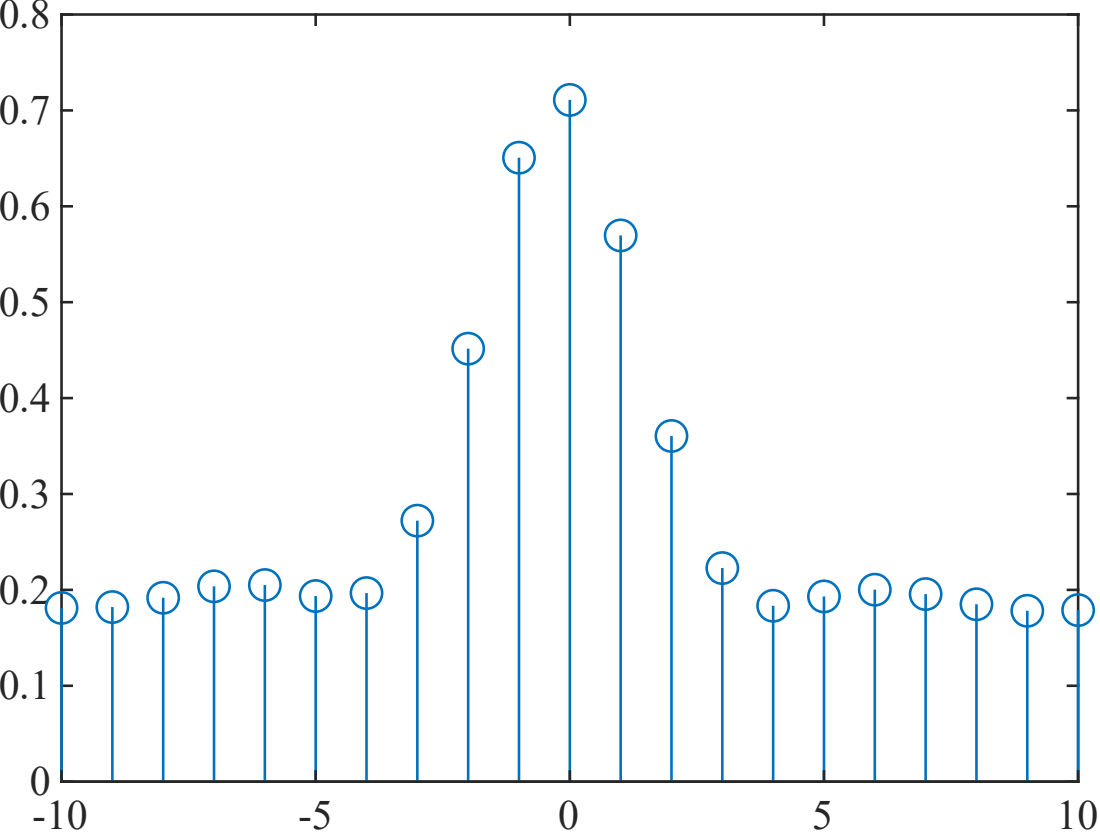
[picture p46: page 1]
