yrxyear/Active-Noise-Cancelling-Method-for-An-Electro-Optical-Detection-System/4-ANC_Sys/CrossCorrelation 35.pdf

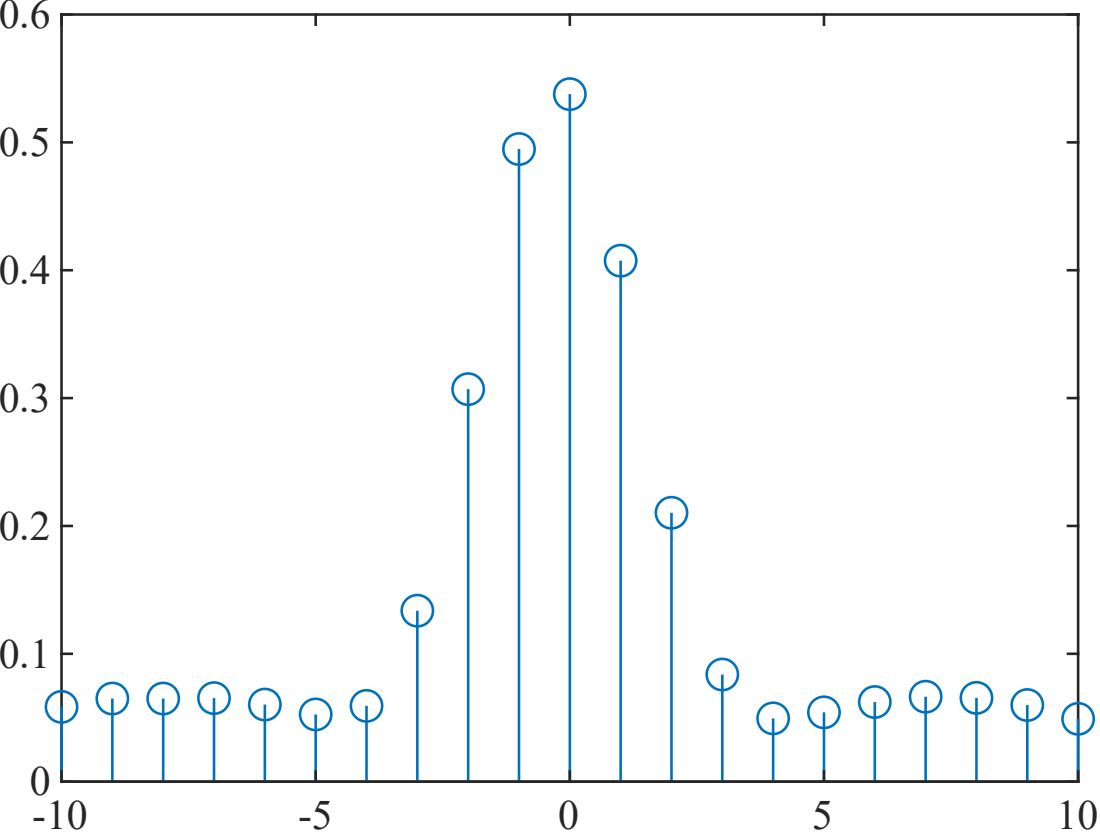
[picture p47: page 1]
