yrxyear/Active-Noise-Cancelling-Method-for-An-Electro-Optical-Detection-System/4-ANC_Sys/CrossCorrelation 36.pdf

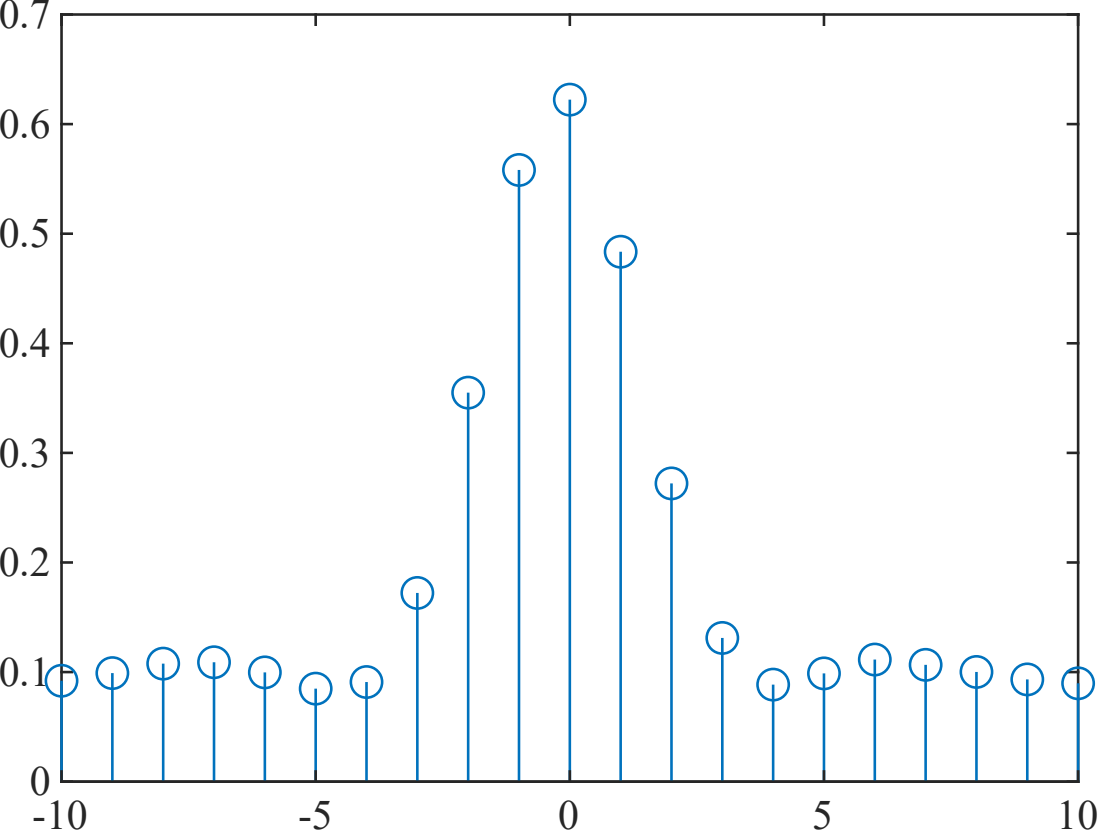
[picture p48: page 1]
