yrxyear/Active-Noise-Cancelling-Method-for-An-Electro-Optical-Detection-System/4-ANC_Sys/DataFlow.pdf

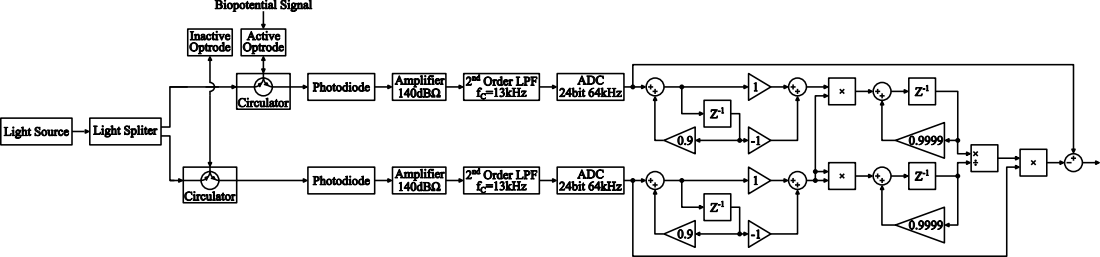
[picture p49: page 1]
