yrxyear/Active-Noise-Cancelling-Method-for-An-Electro-Optical-Detection-System/4-ANC_Sys/FibreReceiver_3c_Input1.pdf

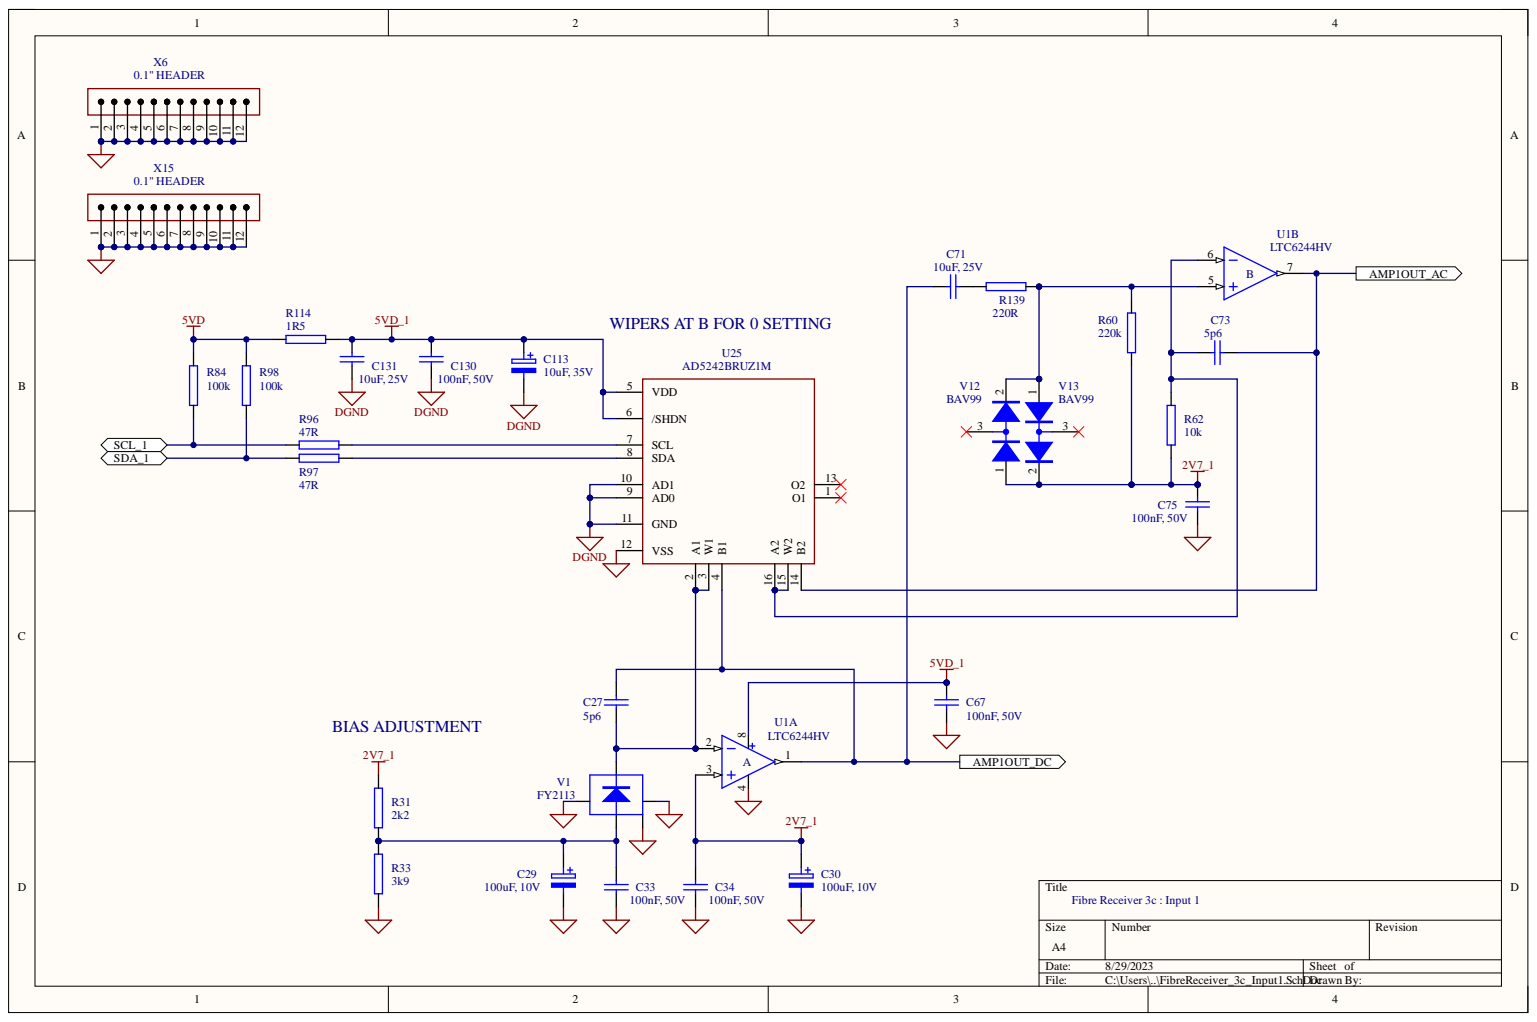
[picture p50: page 1]

WIPERS AT B FOR 0 SETTING
