yrxyear/Active-Noise-Cancelling-Method-for-An-Electro-Optical-Detection-System/4-ANC_Sys/FibreReceiver_3c_Output1.pdf

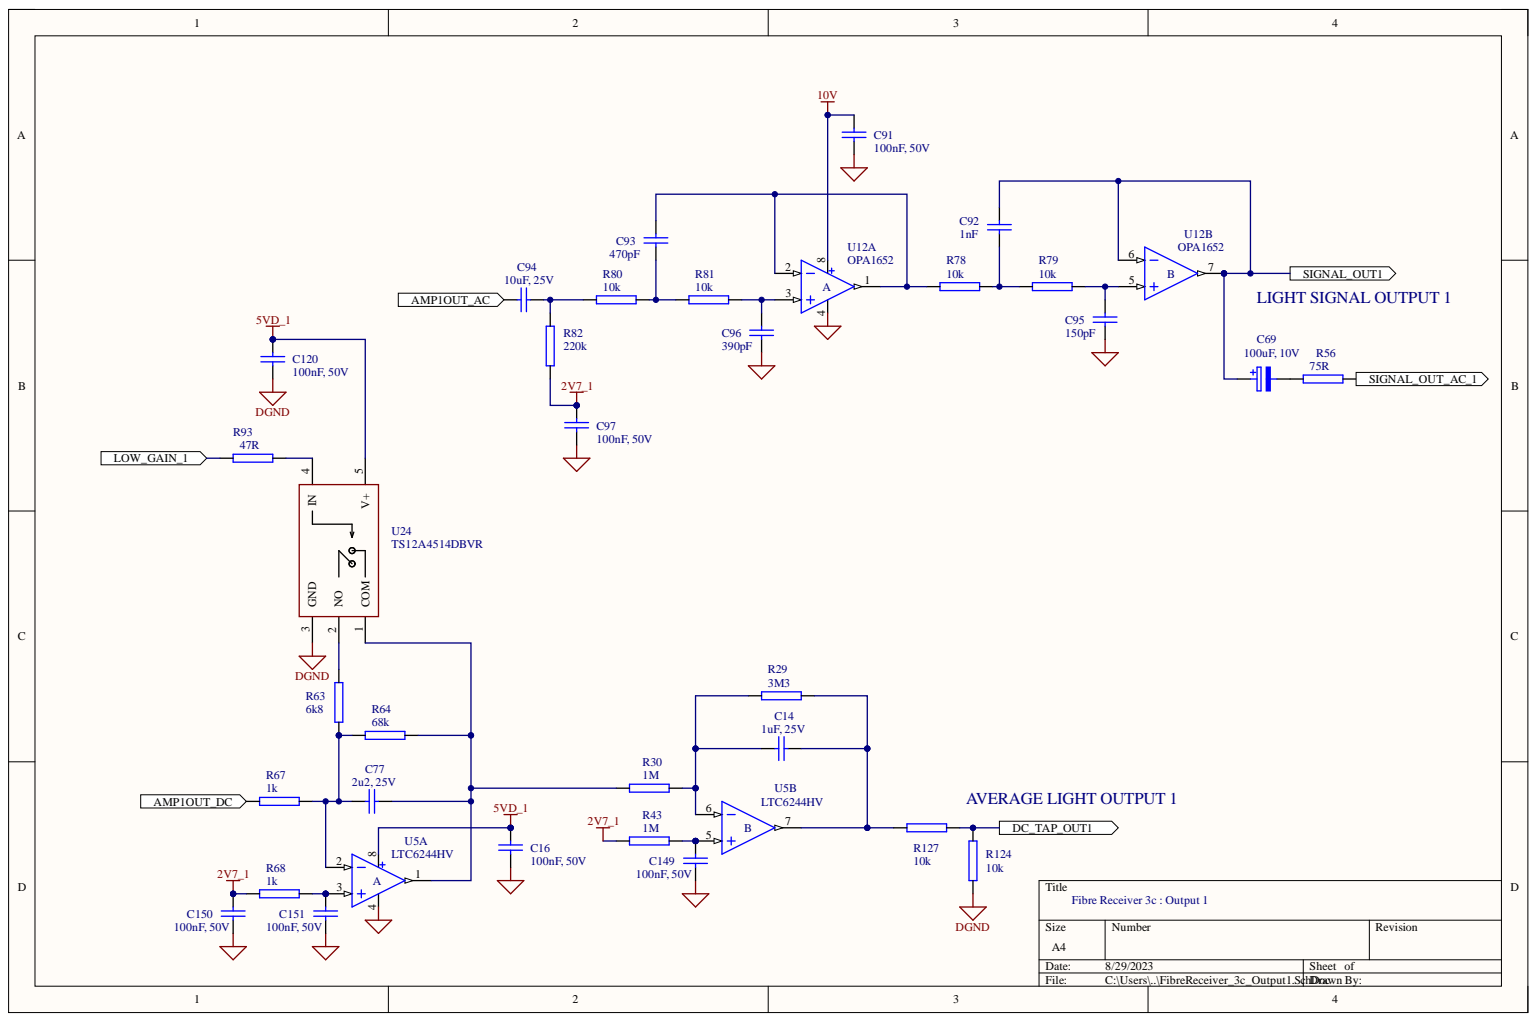
[picture p51: page 1]
