yrxyear/Active-Noise-Cancelling-Method-for-An-Electro-Optical-Detection-System/4-ANC_Sys/LTspiceLPFSch.pdf

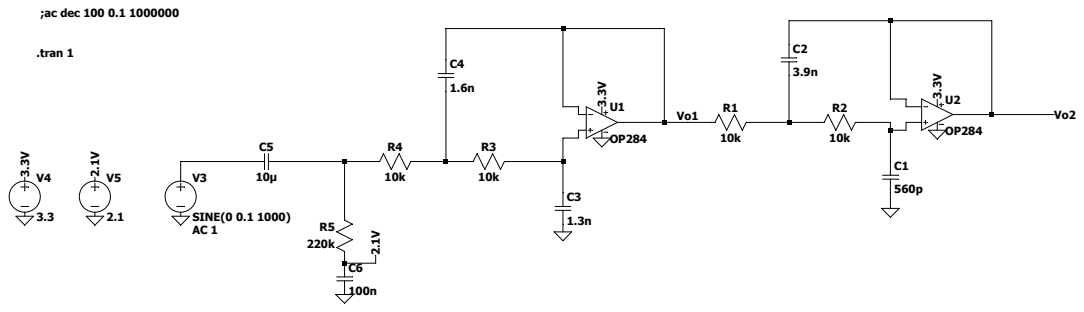
[picture p52: page 1]
