yrxyear/Active-Noise-Cancelling-Method-for-An-Electro-Optical-Detection-System/4-ANC_Sys/PCB1_24-5-2023.pdf

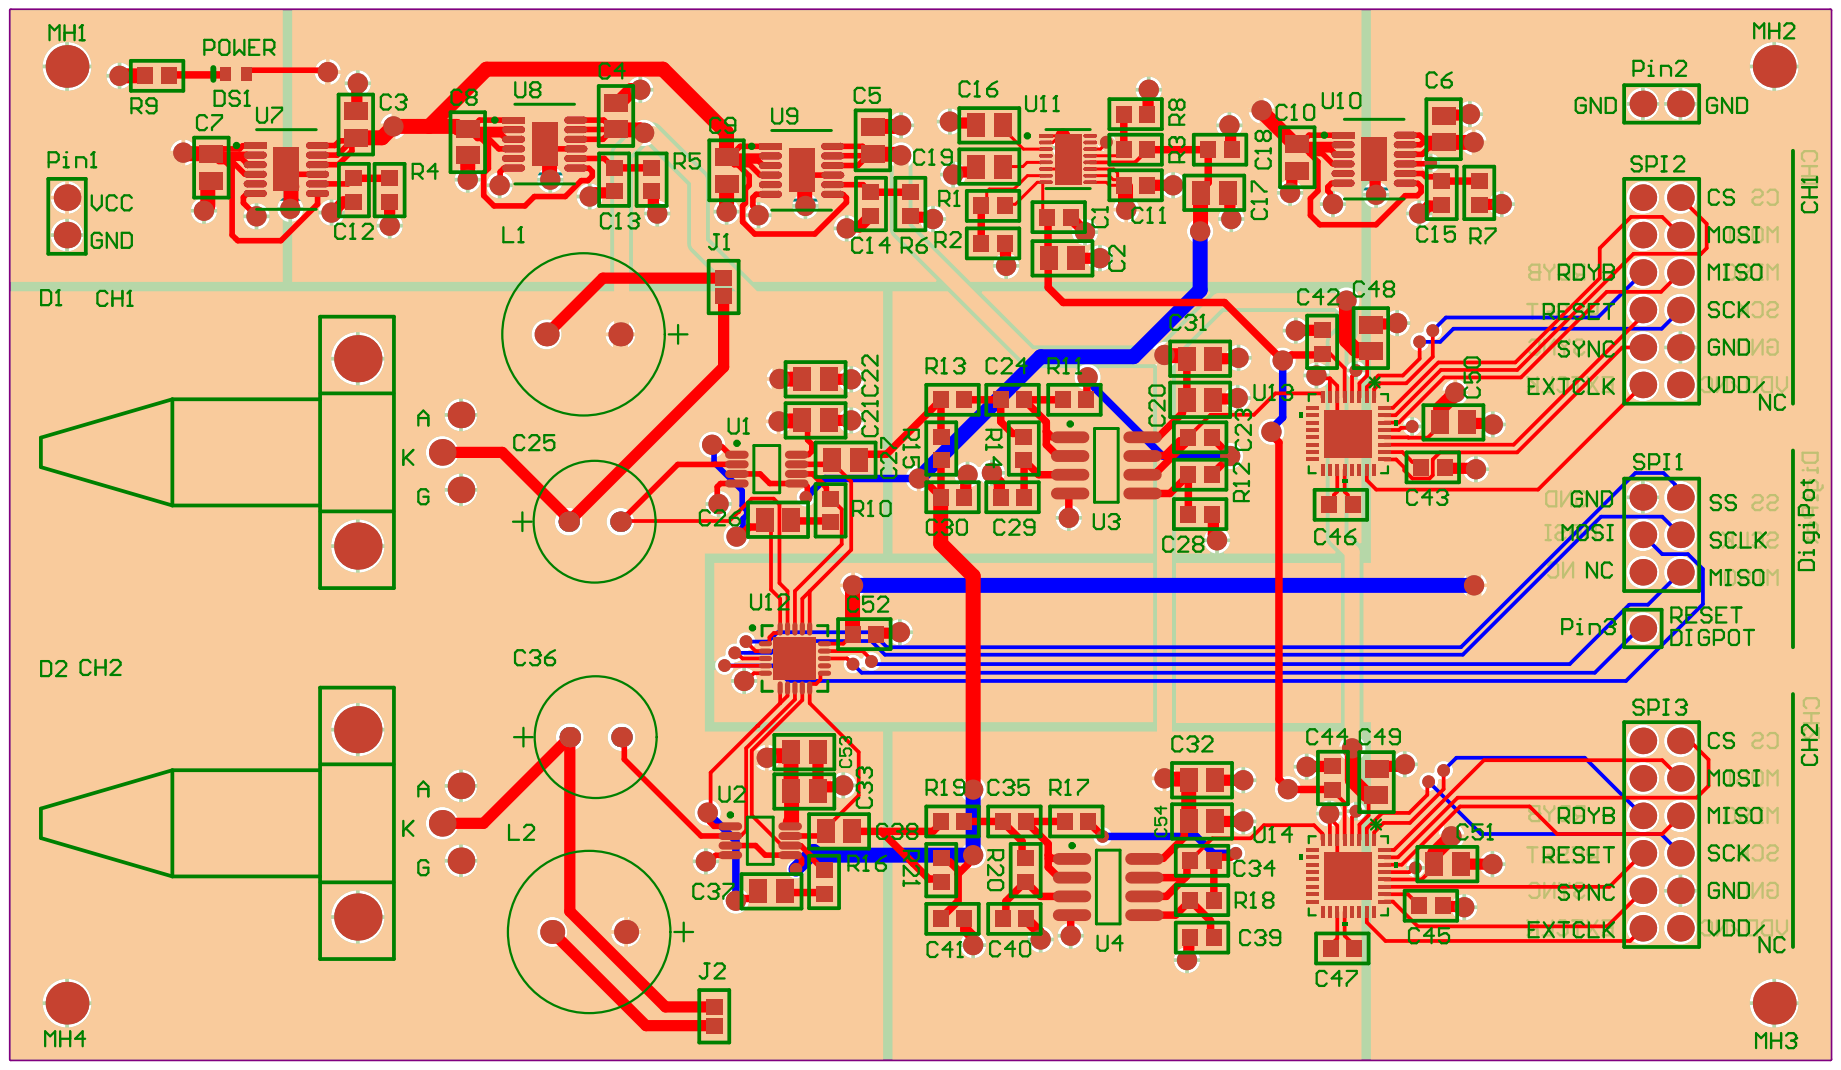
[picture p53: page 1]
