yrxyear/Active-Noise-Cancelling-Method-for-An-Electro-Optical-Detection-System/4-ANC_Sys/ReceiverSch.pdf

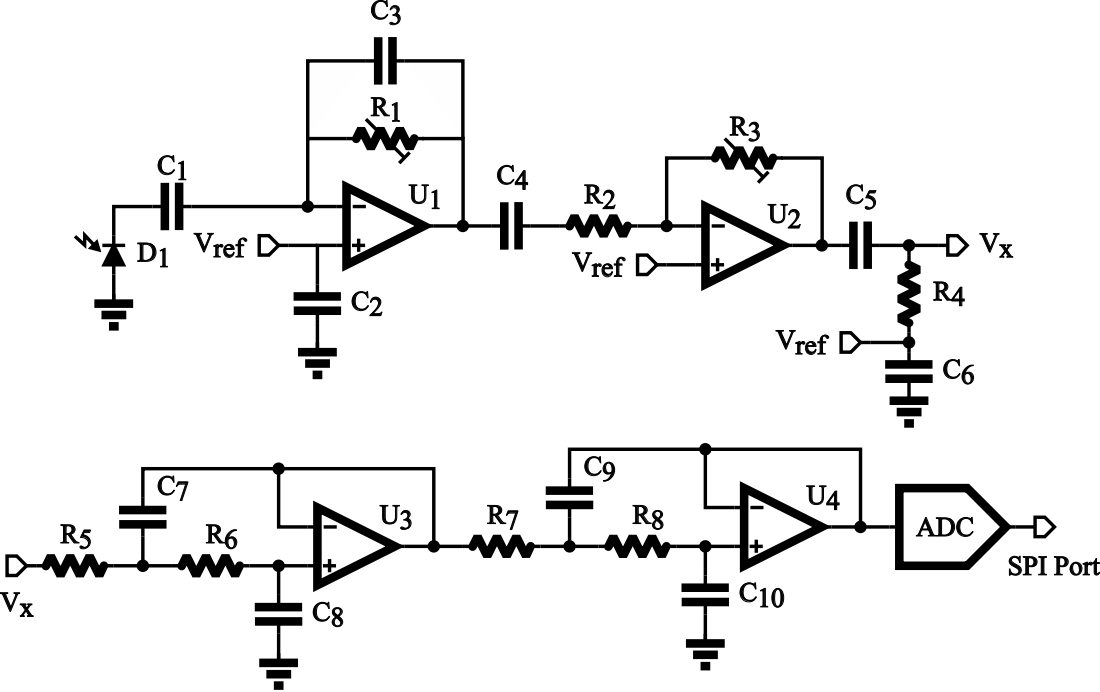
[picture p54: page 1]
