yrxyear/Active-Noise-Cancelling-Method-for-An-Electro-Optical-Detection-System/4-ANC_Sys/Simulink.pdf

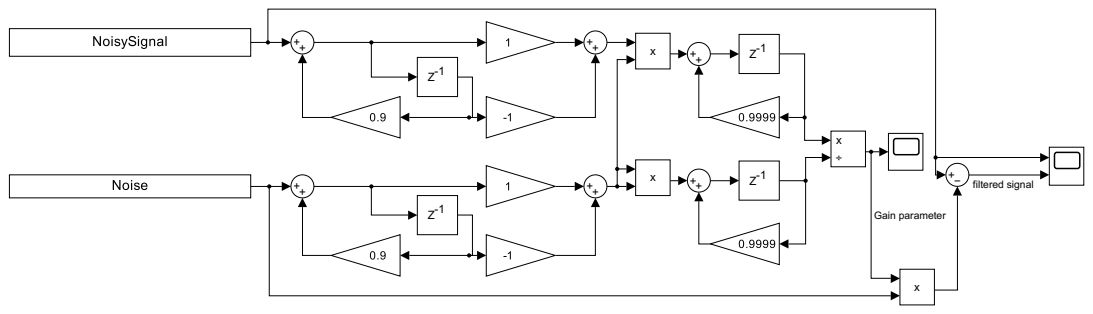
[picture p55: page 1]
ain; filt; sig
