yrxyear/Active-Noise-Cancelling-Method-for-An-Electro-Optical-Detection-System/8-appendices/Codes/Step_input.v

`timescale 1ns / 1ps
//////////////////////////////////////////////////////////////////////////////////
// Company: 
// Engineer: 
// 
// Create Date: 07.06.2022 11:04:22
// Design Name: 
// Module Name: Step_input
// Project Name: 
// Target Devices: 
// Tool Versions: 
// Description: 
// 
// Dependencies: 
// 
// Revision:
// Revision 0.01 - File Created
// Additional Comments:
// 
//////////////////////////////////////////////////////////////////////////////////


module Step_input(
    input clk,
    output reg signed [15:0] step_out
    );
    
    /*
    initial begin
        #1;
        step_out = 16'h0000;
    end
    
    initial begin
        #110;
        step_out = 16'hFFEF;
    end
    
    initial begin
        #800;
        step_out = 16'h00FF;
    end
    */
    
    initial begin
        #20;
        step_out = 16'h0080;
        #20;
        step_out = 16'hFF6C;
        #20;
        step_out = 16'h002C;
        #20;
        step_out = 16'h0098;
        #20;
        step_out = 16'h00D9;
        #20;
        step_out = 16'h00BE;
        #20;
        step_out = 16'h004E;
        #20;
        step_out = 16'h018B;
        #20;
        step_out = 16'hFFE7;
        #20;
        step_out = 16'hFFA7;
        #20;
        step_out = 16'h00C5;
        #20;
        step_out = 16'h0038;
        #20;
        step_out = 16'hFF90;
        #20;
        step_out = 16'h0002;
        #20;
        step_out = 16'hFF9E;
        #20;
        step_out = 16'hFFEC;
        #20;
        step_out = 16'h001B;
        #20;
        step_out = 16'h00C5;
        #20;
        step_out = 16'hFFC7;
        #20;
        step_out = 16'h0017;
        #20;
        step_out = 16'h0064;
        #20;
        step_out = 16'hFF44;
        #20;
        step_out = 16'hFF70;
        #20;
        step_out = 16'hFF2A;
        #20;
        step_out = 16'hFFC4;
        #20;
        step_out = 16'hFFE4;
        #20;
        step_out = 16'h004A;
        #20;
        step_out = 16'h0049;
        #20;
        step_out = 16'h00AB;
        #20;
        step_out = 16'h007A;
        #20;
        step_out = 16'hFF2B;
        #20;
        step_out = 16'hFFDC;
        #20;
        step_out = 16'h013C;
        #20;
        step_out = 16'h009F;
        #20;
        step_out = 16'h0099;
        #20;
        step_out = 16'h000F;
        #20;
        step_out = 16'h00DD;
        #20;
        step_out = 16'hFFF6;
        #20;
        step_out = 16'hFFC8;
        #20;
        step_out = 16'hFFCB;
        #20;
        step_out = 16'hFFFA;
        #20;
        step_out = 16'hFF75;
        #20;
        step_out = 16'h009D;
        #20;
        step_out = 16'hFF6C;
        #20;
        step_out = 16'hFEEB;
        #20;
        step_out = 16'hFF1F;
        #20;
        step_out = 16'hFFAB;
        #20;
        step_out = 16'hFF89;
        #20;
        step_out = 16'hFFEE;
        #20;
        step_out = 16'hFF5A;
        #20;
        step_out = 16'hFF8D;
        #20;
        step_out = 16'hFFE1;
        #20;
        step_out = 16'h004A;
        #20;
        step_out = 16'h0021;
        #20;
        step_out = 16'hFFB8;
        #20;
        step_out = 16'h007E;
        #20;
        step_out = 16'hFFEB;
        #20;
        step_out = 16'hFFEC;
        #20;
        step_out = 16'h00CF;
        #20;
        step_out = 16'hFFF2;
        #20;
        step_out = 16'hFF2F;
        #20;
        step_out = 16'hFF9D;
        #20;
        step_out = 16'h0032;
        #20;
        step_out = 16'h001A;
        #20;
        step_out = 16'h0066;
        #20;
        step_out = 16'h00A1;
        #20;
        step_out = 16'h001C;
        #20;
        step_out = 16'h00E5;
        #20;
        step_out = 16'h0016;
        #20;
        step_out = 16'hFFD8;
        #20;
        step_out = 16'h0124;
        #20;
        step_out = 16'h008E;
        #20;
        step_out = 16'h00E2;
        #20;
        step_out = 16'h00BD;
        #20;
        step_out = 16'h007B;
        #20;
        step_out = 16'h0021;
        #20;
        step_out = 16'h009A;
        #20;
        step_out = 16'h00CD;
        #20;
        step_out = 16'h004B;
        #20;
        step_out = 16'h0054;
        #20;
        step_out = 16'h009C;
        #20;
        step_out = 16'h00A0;
        #20;
        step_out = 16'h0030;
        #20;
        step_out = 16'h011E;
        #20;
        step_out = 16'h00A0;
        #20;
        step_out = 16'h0060;
        #20;
        step_out = 16'h0064;
        #20;
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
        #20;
        step_out = 16'hF557;
        #20;
        step_out = 16'hF3B3;
        #20;
        step_out = 16'hF44D;
        #20;
        step_out = 16'hF440;
        #20;
        step_out = 16'hF3E3;
        #20;
        step_out = 16'hF3FB;
    end
    
endmodule
