yrxyear/Active-Noise-Cancelling-Method-for-An-Electro-Optical-Detection-System/8-appendices/Codes/bit64_adder.v

`timescale 1ns / 1ps
//////////////////////////////////////////////////////////////////////////////////
// Company: 
// Engineer: 
// 
// Create Date: 30.06.2022 13:53:08
// Design Name: 
// Module Name: bit64_adder
// Project Name: 
// Target Devices: 
// Tool Versions: 
// Description: 
// 
// Dependencies: 
// 
// Revision:
// Revision 0.01 - File Created
// Additional Comments:
// 
//////////////////////////////////////////////////////////////////////////////////


module bit64_adder(
    input signed [63:0] in1,
    input signed [63:0] in2,
    output wire signed [63:0] out1
    );
    
    assign out1 = in1 + in2;
    
endmodule
